rielvanm/VRI_Datalogger_/Tussentijdse_rapportage/5 april1.jpg

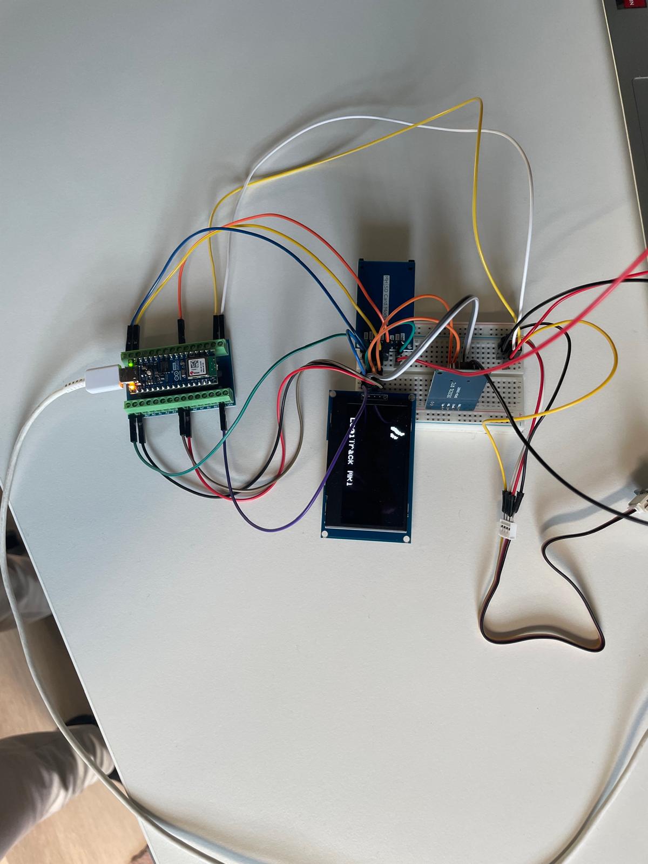
Tussentijdse_rapportage/5 april1.jpg
