rielvanm/VRI_Datalogger_/Tussentijdse_rapportage/iCloud‑foto’s/iCloud‑foto’s/IMG_2985.JPEG

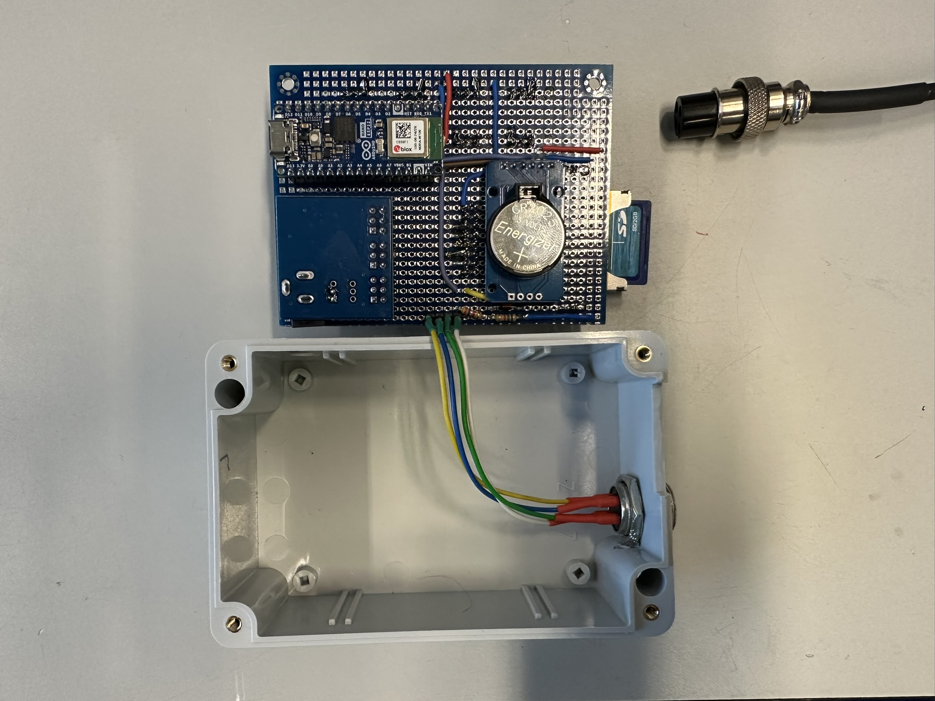
Tussentijdse_rapportage/iCloud‑foto’s/iCloud‑foto’s/IMG_2985.JPEG
