rielvanm/VRI_Datalogger_/Productdocument_bijlagen/Ontwerp.pptx

12V aansluiting

Oled-scherm 128X64 pixels
Afmeting: 6X4 cm

SD Gereed
Tijd: 21:17;23
Dat: 2025-03-14
Meting gestopt

IR: X

SD: 0

RIT:

00

Stop

Start

Klok

GPS

Behuizing maximaal 12x8x5cm (lxbxh)

Ingang lichtpoortsensor

Vier buttons
