rielvanm/VRI_Datalogger_/Plan van Aanpak/Onderzoek.docx

Onderzoeksvraag:

"Welke hard- en software is het meest efficiënt en effectief voor een datalogger, die nauwkeurig de tijdwaarneming kan loggen na een inkomend signaal?"

1. Opdelen van de vraag in subvragen:

- Wat zijn de functionele eisen voor een datalogger met nauwkeurige tijdsregistratie?
  - Wat betekent "nauwkeurige tijdwaarneming" in deze context? (milliseconden, microseconden, nanoseconden?)

De datalogger moet in 0,1 milliseconden registreren. Deze frequentie is ook vastgelegd in een FO-norm, waarin de validatie van verkeersregelinstallaties moeten plaatsvinden. Daarnaast registeren de dataloggers die momenteel in bezit zijn bij de politie, ook in 0,1 ms. Er is geen reden om de nauwkeurigheid te vergroten of te verminderen.

  - Welke soorten signalen moeten worden geregistreerd? (digitaal, analoog, pulsbreedte, etc.)

Noodzakelijk voor de datalogger zijn de volgende signalen (voor de latere modules):

Digitaal → Voor schakelaars en detectiesensoren (O5D150 digitale uitgang, knoppen, GPS-data);

Analoog → Voor continue metingen zoals afstand (O5D150 analoge uitgang, na spanningsdeler);

Seriële data (UART/I²C/SPI) → Voor communicatie met display, SD-kaart, RTC en GPS.

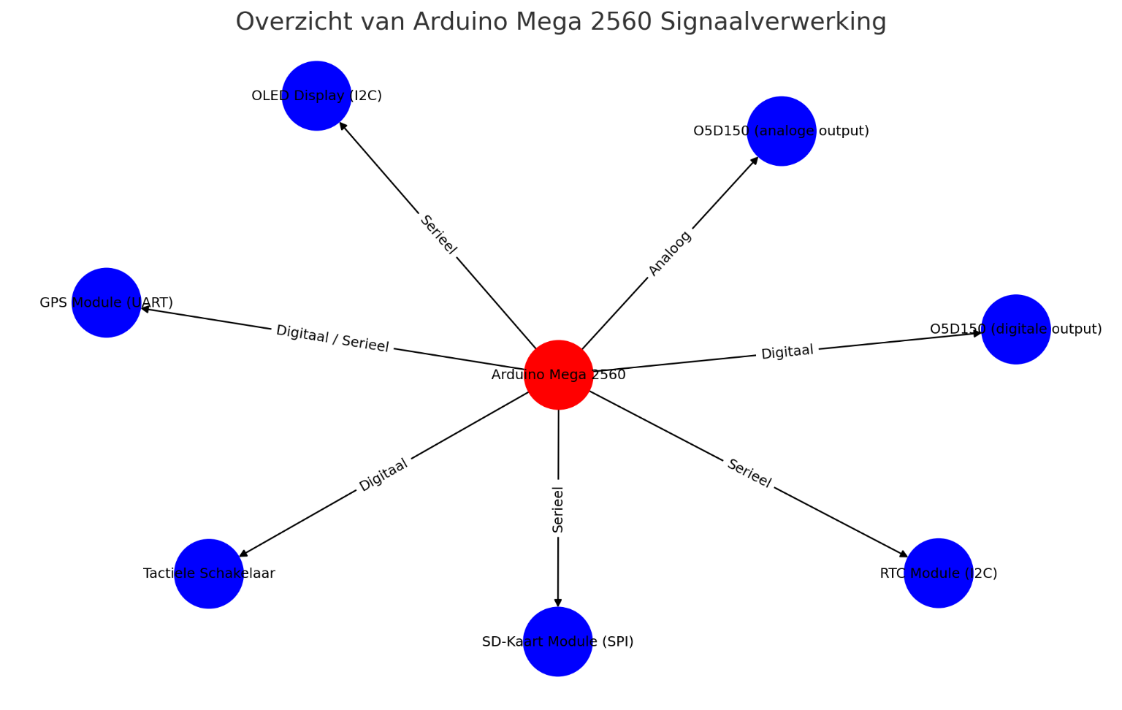
[picture p24: figure]
Uitvoerafbeelding

- Welke hardwarecomponenten zijn geschikt voor een datalogger met hoge tijdsnauwkeurigheid?
  - Welke microcontrollers, FPGA’s of andere embedded systemen kunnen dit aan?

Microcontrollers en Embedded Systemen:

- STM32-serie: Deze microcontrollers van STMicroelectronics staan bekend om hun hoge prestaties en nauwkeurige timers, wat essentieel is voor tijdkritische toepassingen.
- ESP32: Een krachtige microcontroller met ingebouwde Wi-Fi en Bluetooth, geschikt voor real-time toepassingen dankzij zijn dual-core processor en precisietimers.
- Teensy 4.1: Een geavanceerde microcontroller met een 600 MHz ARM Cortex-M7 processor, die hoge snelheid en nauwkeurigheid biedt voor datalogging.

FPGA's (Field-Programmable Gate Arrays):

- Xilinx Spartan-serie: Deze FPGA's bieden hoge mate van parallelisme en kunnen complexe, tijdkritische taken met minimale latentie uitvoeren.
- Intel Cyclone-serie: Bekend om hun efficiëntie en prestaties, geschikt voor toepassingen die een hoge tijdsnauwkeurigheid vereisen.

Voordelen van FPGA's:

- Parallelle verwerking: FPGA's kunnen meerdere processen gelijktijdig uitvoeren, wat resulteert in minimale latentie.
- Hoge flexibiliteit: Ze kunnen worden geherconfigureerd voor specifieke taken, wat ze geschikt maakt voor diverse toepassingen.

Nadelen van FPGA's:

- Complexiteit in programmering: Het vereist gespecialiseerde kennis van hardware description languages zoals VHDL of Verilog.
- Hogere kosten: Zowel de hardware als de ontwikkeltools kunnen duurder zijn in vergelijking met microcontrollers.
  - Wat zijn de voordelen en nadelen van verschillende hardwareplatformen (bijv. Arduino, Raspberry Pi, STM32, KL25Z, FPGA’s)?

Platform | Voordelen | Nadelen
Arduino | - Gebruiksvriendelijk en breed ondersteund. - Ideaal voor beginners en snelle prototyping. | - Beperkte rekenkracht en precisie. - Minder geschikt voor zeer tijdkritische toepassingen. - Geen RTOS (Wel ondersteuning voor FreeRTOS)
Raspberry Pi | - Krachtige single-board computer met uitgebreide connectiviteitsopties. - Geschikt voor complexe toepassingen en dataverwerking. | - Draait op een besturingssysteem, wat kan leiden tot minder voorspelbare timing. - Hogere stroomverbruik.
STM32 | - Hoge prestaties met nauwkeurige timers. - Lage stroomverbruik, geschikt voor embedded toepassingen. | - Complexere ontwikkelomgeving vergeleken met Arduino. - Vereist meer technische kennis.
KL25Z | - Kosteneffectief met redelijke prestaties. - Ondersteuning voor diverse interfaces. | - Minder krachtige processor in vergelijking met STM32. - Beperkte community-ondersteuning.
FPGA's | - Uitstekende parallelle verwerking en lage latentie. - Hoge mate van flexibiliteit en herconfigureerbaarheid. | - Hoge complexiteit in ontwerp en implementatie. - Hogere kosten en stroomverbruik. - Beperkte RTOS ondersteuning

  - Welke externe componenten kunnen helpen (bijv. RTC’s, GPS-modules, kristaloscillatoren)?
- RTC's (Real-Time Clocks): Deze modules bieden nauwkeurige tijdkeeping en zijn essentieel voor toepassingen die exacte tijdstempels vereisen.
- GPS-modules: Naast locatie-informatie kunnen GPS-modules zeer nauwkeurige tijdsignalen leveren, gesynchroniseerd met atoomklokken, wat cruciaal is voor systemen die absolute tijdsynchronisatie nodig hebben.
- Kristaloscillatoren: Hoge-precisie kristaloscillatoren kunnen de klokstabiliteit van microcontrollers verbeteren, wat leidt tot betere tijdsnauwkeurigheid in dataloggingtoepassingen.

### Conclusie

De keuze van hardware voor een datalogger met hoge tijdsnauwkeurigheid hangt af van de specifieke eisen van mijn project. Microcontrollers zoals de STM32 bieden een balans tussen prestaties en complexiteit, terwijl FPGA's ongeëvenaarde snelheid en flexibiliteit bieden voor zeer tijdkritische toepassingen. Het integreren van externe componenten zoals RTC's, GPS-modules en hoogwaardige kristaloscillatoren kan de tijdsnauwkeurigheid verder verbeteren.

- Welke softwareframeworks en programmeertalen zijn geschikt?
  - Welke softwarebibliotheken of frameworks ondersteunen precieze tijdsregistratie?

Er zijn meerdere bibliotheken en frameworks die geschikt zijn voor precieze tijdsregistratie in embedded systemen en dataloggers. De keuze hangt af van de hardware en de gewenste nauwkeurigheid.

- Voor microcontrollers en real-time systemen
  - FreeRTOS (Real-Time OS voor embedded systemen)
    - Ondersteunt precieze timers en scheduling met prioriteiten.
    - Geschikt voor STM32, ESP32, Arduino, en andere microcontrollers.
  - mbed OS (van ARM)
    - Ondersteunt low-latency hardware-interrupts en tijdmeting.
  - Arduino Time Library
    - Beschikbaar voor eenvoudige dataloggers die millisecondenprecisie vereisen.
- Voor Linux-gebaseerde embedded systemen
  - Linux clock_gettime() API
    - Ondersteunt resoluties tot nanoseconden, afhankelijk van de gebruikte hardware.
  - Xenomai (Real-Time Linux Extension)
    - Voegt real-time capaciteiten toe aan Linux voor microseconden-nauwkeurigheid.
  - RT-PREEMPT Kernel Patch
    - Zorgt ervoor dat Linux geschikt is voor real-time toepassingen.
- Voor FPGA-gebaseerde datalogging
  - Verilog/VHDL met Precision Timing Modules
    - Voor ultra-lage latency tijdsregistratie (nanoseconden-niveau).
  - Xilinx Vitis & Intel Quartus Timing Analysis
    - Voor FPGA-gebaseerde tijdstempellogging met sub-nanoseconden precisie.
  - Wat zijn de verschillen tussen real-time besturingssystemen (RTOS) en standaard besturingssystemen zoals Linux?

Kenmerk | RTOS (Real-Time OS) | Linux (standaard OS)
Tijdsresolutie | Microseconden tot nanoseconden | Milliseconden tot microseconden
Determinisme | Zeer voorspelbaar | Minder voorspelbaar (afhankelijk van scheduler)
Gebruik in embedded systemen | Geschikt voor microcontrollers | Geschikt voor SBC’s zoals Raspberry Pi
Voorbeelden | FreeRTOS, Zephyr, mbed OS | Ubuntu, Debian, Yocto Linux
Toepassingen | Industriële besturing, precisie-logging | Servertoepassingen, complexe dataverwerking

Conclusie: Als ik zeer nauwkeurige en deterministische tijdregistratie nodig heb (bijv. ≤ 1 µs), is RTOS of een FPGA-oplossing geschikter. Voor minder kritische toepassingen kan Linux met een real-time patch voldoen.

  - Welke programmeertalen zijn het meest geschikt voor het verwerken van inkomende signalen met minimale vertraging?
- C / C++
  - Efficiënt en direct toegankelijk tot hardware.
  - Wordt gebruikt in microcontrollers en RTOS (FreeRTOS, Zephyr).
- Rust
  - Biedt lage latency en veilig geheugenbeheer (handig voor complexe systemen).
  - Wordt steeds vaker gebruikt in embedded toepassingen.
- Python met C-extensies
  - Niet real-time geschikt, maar handig voor snelle prototyping en data-analyse.
  - Kan met NumPy of Cython worden geoptimaliseerd.
- Verilog/VHDL (voor FPGA's)
  - Uiterst geschikt voor ultrasnelle tijdsregistratie.

Conclusie: C/C++ is de standaardkeuze voor embedded real-time verwerking, terwijl Rust opkomt als veilig alternatief. Python kan nuttig zijn voor analyse na de datalogging.

- Hoe kan de efficiëntie en effectiviteit van verschillende hardware- en softwarecombinaties worden vergeleken?
  - Wat zijn de meetcriteria voor efficiëntie (energieverbruik, snelheid, latency, opslagcapaciteit)?

A. Energieverbruik (mW of mAh)

- Waarom belangrijk? In batterijgevoede systemen bepaalt het energieverbruik de operationele levensduur.
- Meetmethode:
  - Gebruik een elektronische belastingmeter of een Shunt-resistor + ADC om het stroomverbruik te meten.
  - Meet in actieve modus, slaapmodus en logging-operatie.
- Tools:
  - Nordic Power Profiler Kit (PPK2) voor embedded hardware.
  - Otii Arc voor geavanceerde energieprofielen.

B. Snelheid (verwerkingssnelheid in kHz of MHz)

- Waarom belangrijk? Hoe sneller de hardware data kan verwerken, hoe minder vertraging er optreedt.
- Meetmethode:
  - Interrupt latency testen: Laat een GPIO-pin een puls genereren en meet de reactietijd van de software.
  - Verwerkingstijd: Log een dataset van vaste grootte en meet hoe snel deze wordt opgeslagen.
  - CPU-gebruik meten: Gebruik ingebouwde timers (bijv. clock() in C) of benchmarking-tools (sysbench op Linux).

C. Latency (in microseconden of nanoseconden)

- Waarom belangrijk? Hoe korter de tijd tussen een inkomend signaal en de logging, hoe beter.
- Meetmethode:
  - Gebruik een oscilloscoop om de vertraging tussen een inkomend signaal en de registratie te meten.
  - Meet software-latency door tijdstempels voor en na verwerking te vergelijken.
  - Vergelijk polling, interrupts en DMA (Direct Memory Access).
- Hardware met lage latency: FPGA’s (Xilinx, Intel), high-end microcontrollers (Teensy 4.1, STM32H7).

D. Opslagcapaciteit (MB/s of GB)

- Waarom belangrijk? Een hoger datavolume vereist snellere en grotere opslag.
- Meetmethode:
  - Meet de maximale datadoorvoer naar SD-kaart, SSD of cloud.
  - Gebruik benchmarktools zoals dd of fio op Linux voor opslagperformance.
  - Hoe kan de effectiviteit worden gemeten (nauwkeurigheid van tijdregistratie, consistentie, fouttolerantie)?

A. Nauwkeurigheid van tijdregistratie (in microseconden of nanoseconden)

- Waarom belangrijk? Hoe beter de nauwkeurigheid, hoe betrouwbaarder de meetdata.
- Meetmethode:
  - Gebruik een referentieklok (bijv. GPS, rubidium-oscillator) en vergelijk tijdstempels.
  - Vergelijk klokken van RTC-modules, interne kristallen en externe oscillatoren.
  - Gebruik phase-locked loops (PLL) voor synchronisatie.

B. Consistentie (herhaalbaarheid van metingen)

- Waarom belangrijk? Variaties in metingen kunnen duiden op hardware- of softwareproblemen.
- Meetmethode:
  - Voer herhaalde tests uit en bereken de standaardafwijking (σ).
  - Check jitter (variatie in latency over de tijd).
  - Gebruik oscilloscopen en data-analyse tools (MATLAB, Python Pandas).

C. Fouttolerantie (resilience tegen storingen)

- Waarom belangrijk? Een betrouwbare datalogger moet kunnen omgaan met storingen.
- Meetmethode:
  - Simuleer spanningsschommelingen en stroomonderbrekingen.
  - Controleer foutcorrectiemechanismen (bijv. CRC-checks, redundante logging).
  - Test met EMI (elektromagnetische interferentie) simulaties.
  - Zijn er benchmarks of eerdere studies over de prestaties van verschillende dataloggers?

A. Wetenschappelijke artikelen en publicaties

- "Real-Time Data Acquisition and Logging for Automotive Applications"
  - IEEE-paper over latency-optimalisatie in CAN-bus datalogging.
- "High-Precision Timestamping in Embedded Systems"
  - arXiv-publicatie over tijdregistratie met FPGA’s en microcontrollers.
- "Power-Efficient Data Logging for IoT Sensors"
  - Springer-publicatie over low-power datalogging optimalisaties.

B. Industriële benchmarks

- Bosch Motorsport Dataloggers (C70, C80)
  - Specificaties over 10 kHz logging, CAN-bus synchronisatie en latencies.
- Raspberry Pi vs. STM32 in real-time logging
  - Vergelijking van Linux-gebaseerde logging versus RTOS-gebaseerde microcontrollers.
- Welke bestaande toepassingen en wetenschappelijke studies kunnen als referentie dienen?
  - Welke wetenschappelijke papers of industriële rapporten zijn er over tijdsregistratie in dataloggers?
  - Zijn er praktijkvoorbeelden uit de automotive sector, industriële monitoring of IoT?

2. Betrouwbare bronnen en methoden om antwoorden te vinden

Om deze deelvragen te beantwoorden, heb je verschillende typen bronnen nodig:

1. Wetenschappelijke artikelen & technische papers
  - Zoek in Google Scholar, IEEE Xplore, arXiv, en ScienceDirect naar papers over tijdregistratie in embedded systemen en datalogging.
  - Gebruik zoektermen zoals:
    - High precision data logging microcontroller
    - Timestamp accuracy in embedded systems
    - Real-time data logging performance FPGA vs. microcontroller
2. Boeken & vakliteratuur
  - Zoek naar boeken over embedded systemen, dataloggers en tijdkritische toepassingen.
  - Websites zoals SpringerLink of MIT Press hebben vaak goede academische boeken.
3. Datasheets en whitepapers van hardwarefabrikanten
  - Voor de hardwarekeuze kun je datasheets van microcontrollers en FPGA’s vergelijken op hun clock precisie, interrupt latency en event timestamping mogelijkheden.
  - Check bijvoorbeeld:
    - NXP KL25Z datasheet (mogelijk interessant voor jouw toepassing)
    - STM32 real-time clock (RTC) en timerfunctionaliteit
    - Xilinx en Intel FPGA’s voor tijdkritische verwerking
4. Open-source projecten en technische blogs
  - Kijk op GitHub, Hackaday, Stack Exchange (Electrical Engineering & Embedded Systems) voor open-source implementaties van dataloggers.
  - Blogs zoals EEVblog, All About Circuits, en Embedded.com geven vaak praktische inzichten over de efficiëntie van hardware en software.
5. Vergelijkende tests en benchmarks
  - Industriële tests of universitaire studies over het vergelijken van verschillende hardware en software voor tijdkritische toepassingen.
  - Zoek naar benchmarks in IEEE-papers over real-time performance in embedded systems.

3. Structuur van je onderzoek

Om je onderzoek logisch en wetenschappelijk onderbouwd te maken, kun je deze structuur hanteren:

1. Inleiding
  - Context: Waarom is nauwkeurige tijdregistratie belangrijk?
  - Probleemstelling: De uitdaging van het kiezen van de juiste hard- en software.
  - Onderzoeksvraag en deelvragen.
2. Theoretisch kader
  - Wat is een datalogger en hoe werkt tijdregistratie?
  - Welke factoren beïnvloeden de precisie?
  - Beschrijving van latency, sampling rates en signaalverwerking.
3. Methodologie
  - Hoe worden verschillende hardware- en softwareoplossingen vergeleken?
  - Welke testopstellingen en meetmethodes worden gebruikt?
4. Resultaten & Analyse
  - Vergelijking van verschillende systemen op basis van nauwkeurigheid, energieverbruik, snelheid.
  - Grafieken en tabellen met meetresultaten.
5. Conclusie & Aanbevelingen
  - Samenvatting van de meest efficiënte en effectieve hardware/software-combinatie.
  - Toepassingsgebieden en verdere onderzoeksmogelijkheden.
