rielvanm/VRI_Datalogger_/Productdocument/Bijlage/Ilustraties/Microcontroller.pptx

Microcontroller

UART

SPI

SPI

I2C

GPIO

initGPS(), updateGPS()

initSD(), writeLine()

initRTC(), getTime(), initDisplay(), showMessage()

readButtons()

ISR:handleInetrrupt()
