rielvanm/VRI_Datalogger_/Productdocument/Bijlage/Ilustraties/Switch.pptx

Microcontroller

ButtonManager

ButtonManager::begin()

ButtonManager::readButtons()

ButtonManager::readSecondButtons()
