rielvanm/VRI_Datalogger_/Plan van Aanpak/Onderzoek_Bijlage/Switch/Switch.pdf

## Tactile Momentary Push Button White 12mm

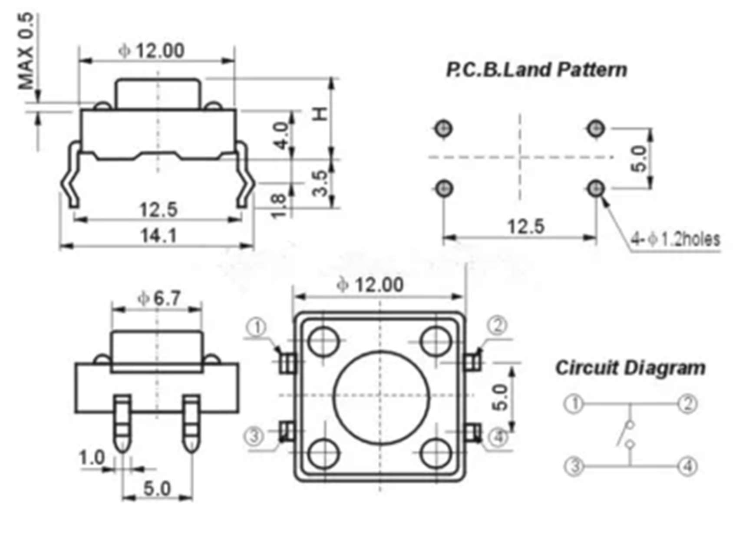
[picture p40: figure]

Description
Momentary contact, round push button, 4 pins, through hole tact switch.
- Push-button Switch
- catching clamps and buttons.
- 12 x 12mm Push Button Switch with white round cap.
- Overall height: 15mm
