rielvanm/VRI_Datalogger_/Op te ruimen/pinbezetting.docx

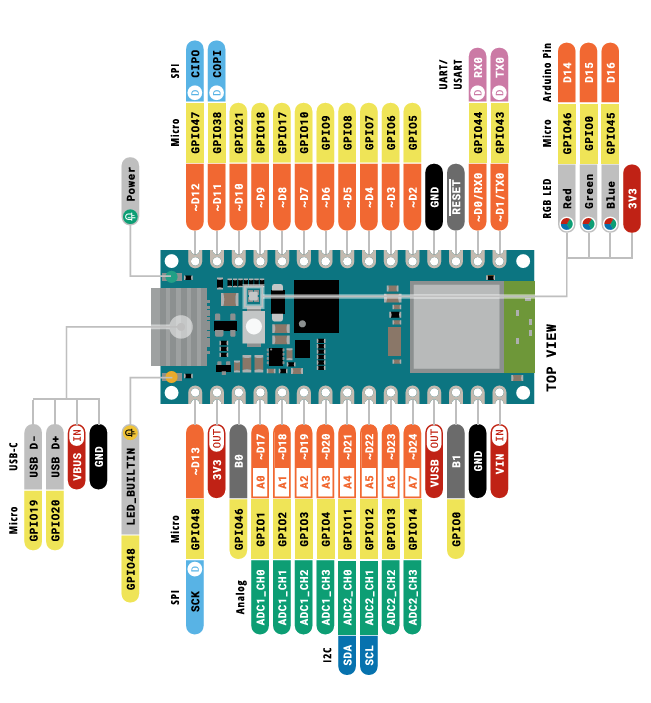
[picture p41: figure]
Afbeelding met tekst, schermopname, diagram, ontwerp Door AI gegenereerde inhoud is mogelijk onjuist.
