rielvanm/VRI_Datalogger_/Plan van Aanpak/Plan van Aanpak.docx

| | Plan van Aanpak Datalogger voor het valideren van tijdwaarneming verkeersregelinstallatie
| | | Student : Maarten van Riel Versie : 0.1 Datum : 30 januari 2025

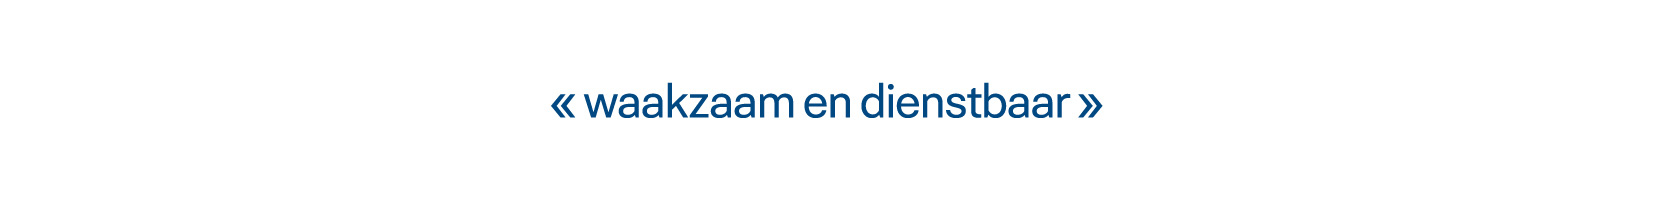
[picture p42: figure]
footer

Eenheid Zeeland – West Brabant

Dienst Regionale Recherche

Afdeling Specialistische Ondersteuning

Team Forensische Opsporing

Postbus 8050

5004 GB Tilburg

Tel. +31 88 9635060

## Algemeen

## Opdrachtgever en betrokkenen

Opdrachtgever : Nationale Politie

Contactpersoon : Mark Bos, (Mark.Bos@politie.nl)

Bezoekadres : Nieuwe Uitleg 1

Postcode / Plaats : 2514 AR Den Haag

Telefoon : 0343 578844

Opdrachtnemer : Politie Zeeland West Brabant

Contactpersoon : Maarten van Riel (Maarten.van.Riel@politie.nl)

Bezoekadres : Ringbaan West 232

Postcode / Plaats : 5038 KE Tilburg

Telefoon : 088-9635060

Docentbegeleider : Hogeschool Arnhem & Nijmegen (HAN)

Contact persoon : Peter Bijl (Peter.Bijl@han.nl)

Bezoekadres : Ruitenberglaan 29

Postcode : 6826 CC, Arnhem (Engineering)

Telefoon : 06 55208764

## Mutatieoverzicht

Datum | Versie | Auteur | Mutaties
30 januari 2025 | 0.1 | M. van Riel | Eerste versie

Tabel 1: Mutatieoverzicht.

# 1 Inleiding

## 1.1 Beknopte beschrijving

Dit plan van aanpak (PvA) beschrijft de aanpak voor het afstudeerproject waarin een embedded apparaat wordt ontworpen en ontwikkeld. Het doel is om een technisch probleem te analyseren, een oplossing te ontwerpen en deze te implementeren. Dit omvat zowel de hardware- als softwareontwikkeling van een datalogger die gebruikt wordt voor forensisch onderzoek naar verkeersongevallen. Het PvA dient als leidraad voor het project en wordt gebruikt om de voortgang te monitoren en afwijkingen te onderbouwen.

## 1.2 Aanleiding

Bij ernstige verkeersongevallen onderzoekt het team Forensische Opsporing de toedracht. Op kruispunten met een verkeersregelinstallatie (VRI) slaat de VRI-computer relevante data op. Wanneer een voertuig het kruispunt nadert, registreert een detectielus verstoringen in het magnetische veld, die worden gelogd. Deze data kan inzicht geven in snelheid en roodlichtnegatie.

Een cruciaal aspect hierbij is de nauwkeurigheid van de tijdstempel. De VRI-computer registreert tijdswaarden met een resolutie van 0,1 seconde (10 Hz), wat kan leiden tot afrondingsverschillen. Deze tijdsregistratie wordt gebruikt om de snelheid van een voertuig tussen de detectielussen te berekenen. De politie gebruikt een datalogger om de tijdstempels van de VRI-computer te valideren en eventuele afrondingsverschillen vast te stellen (zie tabel 2). Een afwijking van 0,1 seconde kan een snelheidsonzekerheid tot 30 km/h veroorzaken.

De huidige datalogger voldoet echter niet meer aan de eisen. De tekortkomingen liggen onder andere op het gebied van verouderde hard- en software en het mist enkele functionaliteiten. Daarom krijg ik de mogelijkheid om een nieuw en verbeterd model te ontwikkelen, met een focus op betrouwbaarheid, gebruiksgemak en toekomstbestendigheid.

## 1.3 Doel document

Dit plan van aanpak dient als leidraad voor de afstudeerperiode en beschrijft de opdracht, methoden en verwachte resultaten. Daarnaast fungeert het als toetsingskader om de voortgang en kwaliteit van het project te bewaken en als communicatiemiddel tussen de betrokken partijen, zoals de opdrachtgever, de begeleider en andere stakeholders.

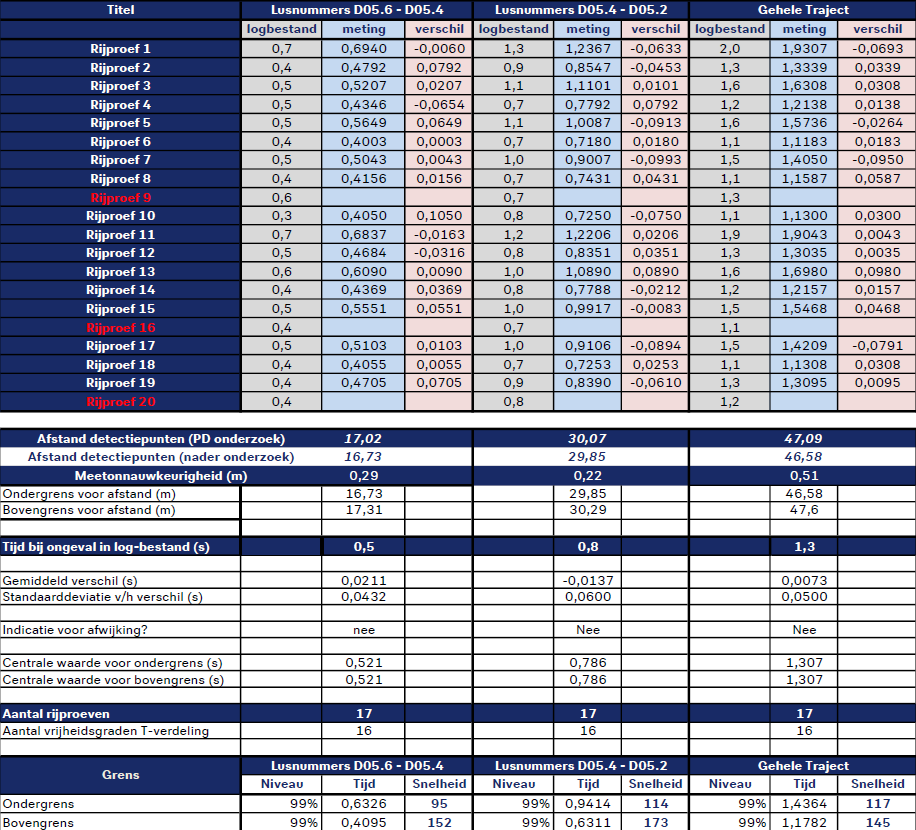
[picture p43: figure]

Tabel 2: Rekenblad van validatieonderzoek (Bron: rechtspraak ECLI:NL:RBZWB:2023:8013).

# 2 Probleemanalyse en opdrachtomschrijving

## 2.1 Probleemstelling

De politie maakt gebruik van verschillende meetinstrumenten. Binnen de nationale politie zijn er 11 teams Forensische Opsporing, waarvoor meetapparatuur bij voorkeur centraal wordt ingekocht. Dit gebeurt meestal via een landelijke aanbesteding, waarbij alle teams inspraak hebben in de functionaliteiten. Omdat de politie vaak specifieke metingen uitvoert, worden er compromissen gesloten om een apparaat te kiezen dat zo breed mogelijk inzetbaar is. Maatwerk wordt zelden overwogen vanwege de hoge kosten en lange levertermijnen.

Meetapparaten gaan gemiddeld tien jaar mee, inclusief onderhoudscontract. Momenteel zijn er verschillende meetinstrumenten in omloop, waaronder een datalogger die wordt gebruikt voor validatieonderzoek bij verkeersregelinstallaties (zie afbeelding 1). Dit apparaat is echter uitgefaseerd; het onderhoudscontract is verlopen en reparaties zijn niet meer mogelijk, want reserveonderdelen zijn nauwelijks verkrijgbaar. De software van de datalogger is niet compatible met de huidige versie van Windows. Hierdoor ontstaat de noodzaak voor een vervangend meetinstrument.

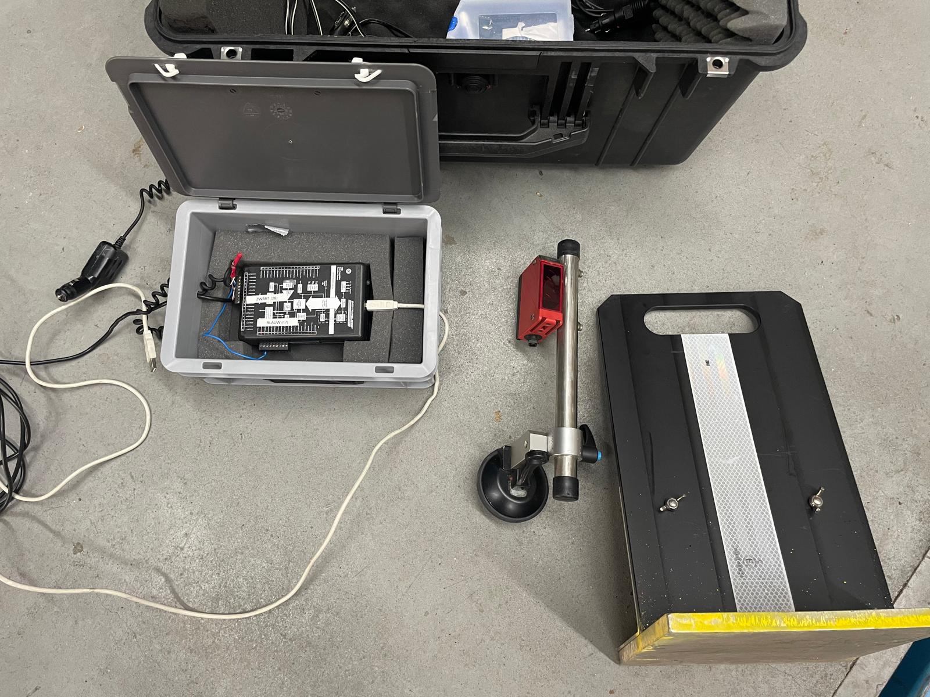
[picture p44: figure]

Afbeelding 1: De huidige datalogger voor de VRI.

## 2.2 Doelstelling

Het doel van dit project is het ontwikkelen van een functionerende prototype-datalogger die tijdens rijproeven nauwkeurig de tijdwaarneming kan vastleggen. Dit apparaat moet de huidige, verouderde datalogger vervangen en specifiek worden ingezet voor de validatie van verkeersregelinstallaties (VRI).

Omdat de afstudeerperiode beperkt is, richt het project zich op het ontwerpen en implementeren van één werkend prototype met een functionele module voor VRI-validatie. De focus ligt op:

- Ontwikkeling van een embedded hardware-oplossing met de juiste aansluitingen en interfaces.
- Implementatie van software/firmware voor het vastleggen en verwerken van meetdata.
- Betrouwbare tijdwaarneming en synchronisatie voor forensisch gebruik.
- Modulariteit, zodat toekomstige functionaliteiten eenvoudig kunnen worden toegevoegd.

Het eindproduct van dit project is een werkend prototype dat voldoet aan de functionele eisen voor VRI-validatie. Volledige implementatie en integratie in politieprocessen vallen buiten de scope.

## 2.3 Eindresultaat

Het eindresultaat van dit project is een functionerende datalogger die tijdens referentieritten betrouwbare meetgegevens registreert en opslaat. De datalogger wordt gebruikt in een referentievoertuig voor de validatie van detectielussen. Aan de buitenzijde van het voertuig wordt een optische sensor toegepast om referentiepunten te detecteren. Met het referentievoertuig worden meerdere referentieritten gereden, met verschillende snelheden. Na afloop worden de tijdwaarnemingen van de datalogger en de computer van de datalogger met elkaar vergeleken om de nauwkeurigheid vast te stellen. De datalogger zal een handzaam formaat krijgen.

De datalogger zal de volgende functionaliteiten bevatten:

- Detectie van referentiepunten met behulp van een optisch meetsysteem;
- Tijdwaarneming met hoge precisie (1000 Hz) voor nauwkeurige positiebepaling;
- Opslag van meetgegevens voor latere analyse en validatie;
- Een gebruikersinterface waarmee instellingen kunnen worden aangepast en meetgegevens kunnen worden gecontroleerd;
- Robuuste en modulaire architectuur, zodat de datalogger eenvoudig kan worden uitgebreid met extra functionaliteiten.

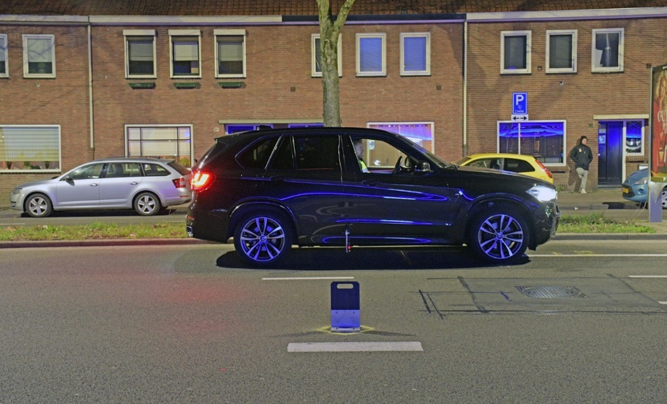
[picture p45: figure]

Afbeelding 2: Referentievoertuig tijdens positioneren lusdetectie.

Om te valideren of de ontwikkelde datalogger correct functioneert, zal een testsysteem worden opgezet waarmee meetresultaten geverifieerd kunnen worden. Dit testsysteem valt binnen de scope van dit project. Dit project richt zich uitsluitend op de ontwikkeling en initiële testfase van de datalogger. Volledige implementatie en integratie in het politieproces vallen buiten de projectomvang.

# 3 Projectactiviteiten en Fasering

Dit project bestaat uit verschillende stappen die ik ga nemen om het project en de afstudeeropdracht te kunnen voltooien. Door mij zijn in dit hoofdstuk een overzicht van de stappen weergegeven en hoe deze in de tijd worden gepland.

3.1 Overzicht Activiteiten

Oriëntatie & Analyse

- Probleemanalyse.
- Wat is de huidige vorm van valideren?
- Gebruikerseisen en randvoorwaarden specificeren.
- Projectplanning.
- Plan van aanpak;

Onderzoek

Hoofdonderzoeksvraag:

Welke hard- en software is het meest efficiënt en effectief voor een datalogger, die nauwkeurig de tijdwaarneming kan vergelijken na een inkomend signaal?

Subvragen:

- Welke hardwarecomponenten zijn geschikt voor het detecteren en verwerken van een inkomend signaal met een hoge nauwkeurigheid?
- Welke software-architectuur zorgt voor een efficiënte verwerking en opslag van tijdstempels?
- Wat zijn de prestatie-eisen voor een nauwkeurige tijdsvergelijking?
- Welke opslag- en verwerkingsmogelijkheden zijn nodig voor langdurige logging?
- Hoe kan de datalogger worden getest en gevalideerd op nauwkeurigheid?

Ontwerp (functioneel en technisch)

- Systeemarchitectuur en interface.
- Gedetailleerd ontwerp van componenten.

Realisatie (prototypeontwikkeling)

- Code schrijven en prototype bouwen.

Documentatie en Oplevering

- Unit testen.
- Integratietesten.
- Systeemtesten.
- Acceptatietesten.
- Systeemvalidatie door het NMI of NFI.
- Oplevering eindproduct.
- Documenteren.

# 4 Kwaliteitswaarborging en Methodologie

Om de kwaliteit van het eindproduct en de uitvoering van het project te borgen, zijn door er kwaliteitseisen, werkwijze en methodes en vastgesteld in dit hoofdstuk.

4.1 Kwaliteitseisen

Het eindproduct moet voldoen aan de volgende kwaliteitseisen:

1. Bedieningsgemak & gebruiksvriendelijkheid
- De interface moet intuïtief en eenvoudig te bedienen zijn.
- Installatie en configuratie moeten duidelijk en zonder specialistische kennis mogelijk zijn.
- Knoppen en menu’s moeten logisch en toegankelijk zijn.
2. Betrouwbaarheid & robuustheid
- Storingen moeten eenvoudig op te lossen zijn, bijvoorbeeld door een foutdiagnosesysteem of logging.
- Het systeem moet langdurig kunnen werken zonder handmatige herstarten of resets.
- Hardware en behuizing moeten bestand zijn tegen trillingen en temperatuurschommelingen.
3. Nauwkeurigheid & prestaties
- De klok moet een frequentie van 1000 Hz (1 ms nauwkeurigheid) halen.
- Latency van signaaldetectie moet minimaal zijn.
- Synchronisatie tussen verschillende componenten moet binnen een acceptabele foutmarge blijven (bijv. max. afwijking ± 1 ms).
4. Opslag & data-integriteit
- Gegevens moeten consistent en foutloos worden weggeschreven naar een USB-stick of SD-kaart.
- Bestandsgrootte en opslagformaat moeten geoptimaliseerd zijn voor snelle uitlezing en verwerking.
- Data mag niet verloren gaan bij een stroomstoring of herstart.
5. Sensorvalidatie & foutpreventie
- Valse detecties van de laserafstandssensor moeten worden geminimaliseerd door filtering of signaalverwerking.
- Omgevingsfactoren (lichtinval, stof, obstakels) mogen de werking niet beïnvloeden.

4.2 Werkwijze en Methodes

Ontwerpmethodologie

- Gevolgd wordt het V-model aanpak: eerst specificeren, ontwerpen, testen en daarna valideren.
- Componenten worden modulair ontworpen zodat aanpassingen per onderdeel mogelijk zijn.
- Documentatie van de software en hardware zodat latere uitbreidingen mogelijk zijn.

Testmethoden

- Unit testing: Elk hardware- en softwarecomponent wordt afzonderlijk getest.
- Integratietesting: De samenwerking tussen componenten wordt getest om communicatieproblemen te detecteren.
- Systeemtesten: De volledige datalogger wordt getest met real-world inputs.
- Validatietesten: De metingen worden vergeleken met een referentieklok om nauwkeurigheid te verifiëren.

Reviewprocessen & feedback

- Wekelijkse evaluaties met praktijkbegeleider.
- Maandelijkse review met externe stakeholders.
- Feedback wordt verwerkt via een versiebeheersysteem.

Versiebeheer

- Gebruik van GitHub.

4.3 Risicomanagement

Bij de ontwikkeling van de nieuwe datalogger zijn er verschillende risico’s die de nauwkeurigheid en betrouwbaarheid kunnen beïnvloeden. In onderstaande tabel staan de belangrijkste risico’s, hun impact en de maatregelen om ze te beheersen.

De focus ligt op een nauwkeurige tijdsregistratie, betrouwbare sensorwaarnemingen en correcte data-opslag. Daarnaast worden mogelijke vertragingen en hardwareproblemen meegenomen in de planning om het project soepel te laten verlopen.

Risico | Impact | Kans | Maatregelen
Nauwkeurigheid lager dan 1000 Hz | Hoog | Middel | Testen met verschillende timers en klokken, optimaliseren code en signaalverwerking.
Sensor detecteert valse signalen | Hoog | Laag | Filtertechnieken implementeren, experimenteren met drempelwaarden.
Data wordt niet correct opgeslagen | Hoog | Middel | Opslagmethodes testen, redundante opslagopties inbouwen (bijv. checksum-controle).
Project loopt uit door technische complexiteit | Hoog | Middel | Strikte planning en prioritering van kritieke onderdelen.
Hardware-componenten niet op tijd beschikbaar | Middel | Hoog | Alternatieve componenten identificeren en testopstelling maken met vervangbare modules.

Tabel 3: Risico inventarisering.

# 5 Projectgrenzen

Het is belangrijk de grenzen van de werkzaamheden te definiëren, omdat de datalogger deel uitmaakt van een groter project. In dit hoofdstuk wordt beschreven welke activiteiten binnen en buiten de scope vallen.

## 5.1 Binnen scope

- Opstellen van eisen: Definitie van functionele en technische eisen.
- Hardware-ontwerp:
  - Selectie en ontwerp van de printplaat (indien nodig).
  - Aansluiting van de microcontroller op sensoren en interface.
  - Voeding en signaalintegriteit.
- Softwareontwikkeling:
  - Microcontroller-code voor data-acquisitie en opslag.
  - Timing en synchronisatie van metingen.
  - Weergave van de live-meetgegevens.
  - Opslag en uitlezing van data.
- Testen en optimaliseren:
  - Valideren van de nauwkeurigheid van de tijdsregistratie.
  - Controleren op storingen en foutafhandeling.
  - Debuggen en optimaliseren van code en signaalverwerking.
- Documentatie:
  - Technische documentatie en gebruikershandleiding.
  - Mogelijkheden voor toekomstige uitbreidingen benoemen.

## 5.2 Buiten scope

- Geavanceerde dataverwerking en analyse: Het verwerken en interpreteren van de verzamelde data gebeurt extern.
- Mechanische behuizing: Geen ontwerp en productie van een specifieke behuizing.
- Ontwerpen van printplaat in Kicad.

# 6 Organisatie en Communicatie

Binnen dit project zijn verschillende belanghebbenden betrokken. Zij hebben een rol in de ontwikkeling, het testen en de uiteindelijke toepassing van de datalogger. Dit hoofdstuk beschrijft wie deze stakeholders zijn en hoe de communicatie met hen wordt vormgegeven.

6.1 Stakeholderanalyse
Men stakeholderanalyse helpt om te bepalen welke partijen belang hebben bij dit project en in welke mate zij invloed uitoefenen. De rollen van stakeholders kunnen worden onderverdeeld in vier categorieën:

- Toeschouwer: Heeft weinig invloed, maar wordt op de hoogte gehouden.
- Geïnteresseerde: Heeft belang bij de uitkomst van het project, maar geen directe invloed.
- Beïnvloeder: Kan de richting van het project bijsturen door advies of eisen.
- Sleutelfiguur: Heeft zowel grote invloed als een groot belang in het project.

In Tabel 1 staat een overzicht van de betrokken stakeholders, hun functie en rol in het project.

Persoon/Organisatie | Functie | Rol
Nikolai Lieshout | Eindgebruiker van de datalogger | Sleutelfiguur/ Beïnvloeder
Forensisch onderzoekers | Gebruikers van de datalogger in het veld | Geïnteresseerde
Peter Bijl | Docentbegleider | Toeschouwer
Mark Bos | Digitaal Rechercheur | Sleutelfiguur/ Beïnvloeder
Aart Spek | Onderzoeker Nederlands Forensisch Instituut | Geïnteresseerde
Softwareontwikkelaar (ik) | Ontwerper en bouwer van het systeem | Sleutelfiguur

Tabel 4: Rolverdeling stakeholders

## 6.2 Communicatie

Een effectieve communicatie tussen de stakeholders is essentieel voor een succesvolle uitvoering van het project. De volgende communicatiemethoden worden gehanteerd:

- Wekelijks overleg met de opdrachtgever om de voortgang te bespreken en feedback te verwerken.
- Periodieke korte rapportages aan de forensisch onderzoekers over testresultaten en functionaliteit.
- Begeleidingsgesprekken met de docent om de afstudeereisen te bewaken (bijv. eens per drie weken).
- Ad-hoc communicatie met hardware- en software-experts via e-mail of Teams bij technische vraagstukken.

Door deze aanpak blijven alle betrokkenen goed geïnformeerd en kan het project efficiënt verlopen.

# 7 Planning

## 7.1 Tijdsplanning en Mijlpalen

Een goed gestructureerde planning is essentieel voor het succesvol afronden van dit project. Tabel 5 geeft een overzicht van de verschillende fases, inclusief de start- en einddata van de activiteiten.

Deze planning dient als richtlijn en is niet leidend. Tegenvallers en uitlopende activiteiten zijn reëel, waardoor sommige onderdelen later kunnen starten dan gepland.

De afstudeerperiode start in week 0 op maandag 3 februari 2025 en eindigt op maandag 2 juni 2025, de uiterste inleverdatum voor de eindrapportage.

Tabel 5: Gantt Chart tijdplanning.

De belangrijkste mijlpalen in dit project zijn (zie rode vlakken in tabel 5):

- Week 3, uiterlijk zondag 2 maart: Afronding Plan van Aanpak.
- Week 6, uiterlijk op zondag 23 maart: Eerste concept Functioneel Ontwerp.
- Week 10, uiterlijk op zondag 20 april: Prototype gereed voor eerste tests.
- Week 13, uiterlijk op zondag 11 mei: Volledige testresultaten beschikbaar.
- Week 14, uiterlijk op zondag 18 mei: Concept Eindrapport gereed.
- Week 16, uiterlijk op maandag 2 juni: Definitieve inlevering eindrapportage.

Omdat ik graag gericht naar deadlines toe werk, zijn mijlpalen in rood gemarkeerd. Zo is direct duidelijk wanneer een onderdeel afgerond moet zijn.

De deadline voor het eindrapport is maandag 2 juni 2025. Het conceptrapport dient uiterlijk zondag 18 mei gereed te zijn, zodat er tijd is om eventuele feedback te verwerken.

## 7.2 Tijdsplanning en Mijlpalen

Het project is opgedeeld in verschillende fasen, waarbij elke fase logisch voortbouwt op de vorige:

1. Initiële onderzoeksfase (Week 1-4): Definitie van eisen, onderzoek en hardwarekeuze.
2. Ontwerpfase (Week 5-9): Opstellen van functioneel en technisch ontwerp, softwareontwikkeling starten.
3. Prototypefase (Week 10-12): Fysiek bouwen en eerste tests uitvoeren.
4. Test- en validatiefase (Week 13-15): Optimalisatie en eindvalidatie van resultaten.
5. Documentatie en afronding (Week 16-17): Rapportage, reflectie en voorbereiden van de eindpresentatie.

Door deze fasering is er voldoende tijd voor ontwikkeling, testen en bijsturing, zodat het eindresultaat aan alle eisen voldoet.

# 8 Competenties en Activiteiten

Tijdens dit project werk ik aan verschillende competenties die aansluiten bij de eisen van de Bachelor Engineering Elektrotechniek, met een specialisatie in Embedded Systems Engineering. In dit hoofdstuk wordt beschreven hoe deze competenties worden toegepast en ontwikkeld. De competenties zijn gebaseerd op de Afstudeergids AD Engineering 2024-2025 (Steenbergen, 2024), waarbij het Domeincompetenties Elektrotechniek (zie Figuur 1) als leidraad is gebruikt.

De mate van competentiebeheersing wordt beoordeeld op vier niveaus, variërend van instroomniveau (0) tot zelfstandig functioneren in complexe, multidisciplinaire contexten (III). Het radarplot in Figuur 1 biedt een visuele weergave van de ontwikkeling van deze competenties binnen de opleiding. In de grafiek vertegenwoordigt de binnenste ring het instroomniveau (0), terwijl de buitenste ring het hoogste niveau (III) aangeeft.

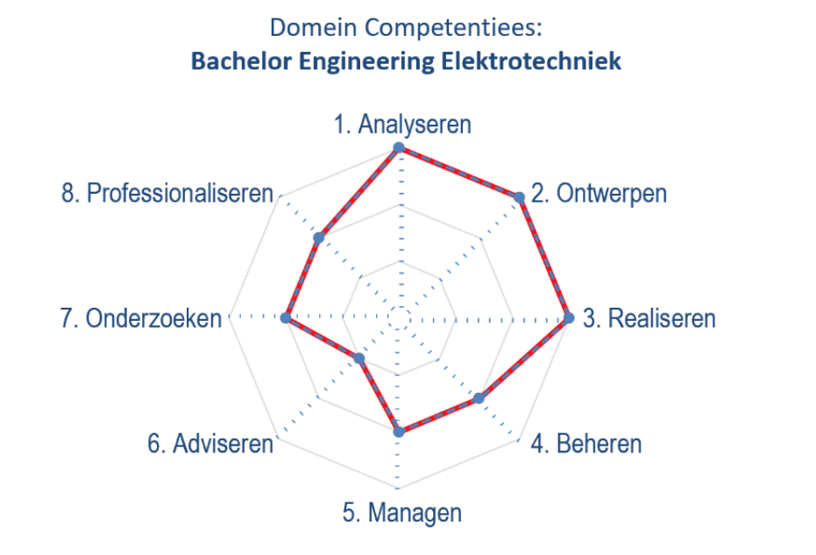
[picture p46: figure]
Afbeelding met tekst, diagram, lijn, schermopname Door AI gegenereerde inhoud is mogelijk onjuist.

Figuur 1: Domein competenties Engineering Elektrotechniek.

## 8.1 SMART Competentiedoelen

1. Analyseren

- Bepalen welke eisen de datalogger moet hebben.
- Controleren hoe nauwkeurig de metingen zijn en waar mogelijke fouten zitten.
- Overleggen met stakeholders om af te stemmen wat de datalogger moet kunnen.
- Onderzoeken welke bestaande systemen en methodes al worden gebruikt voor datalogging.

2. Ontwerpen

- Ontwikkelen van een functioneel en technisch ontwerp voor de datalogger.
- Opstellen van software- en hardware-architectuur.
- Bepalen van de noodzaak en opzet van een testomgeving.
- Keuze en implementatie van geschikte opslag- en communicatiemethoden.

3. Realiseren

- Implementeren van de firmware voor de datalogger.
- Bouwen van een werkend prototype en eerste functionele tests uitvoeren.
- Het systeem verbeteren op basis van testresultaten.

4. Beheren

- Opstellen en bewaken van de projectplanning en fasering.
- Documenteren van ontwerpkeuzes, testresultaten en optimalisaties.
- Structureren van code en hardware keuzes voor toekomstige uitbreidingen.
- Periodieke rapportage aan begeleiders en stakeholders.

5. Managen

- Zorgen voor een tijdige en succesvolle afronding van het project.
- Prioriteren van taken en efficiënte tijdsindeling waarborgen.
- Problemen en tegenslagen signaleren en hierop anticiperen.
- Zorgen voor een goede afstemming met stakeholders en gebruikers.

6. Adviseren

- Stakeholders informeren over de mogelijkheden en beperkingen van de datalogger.
- Beoordelen of de gekozen oplossing voldoet aan de forensische eisen.

7. Onderzoeken

- Vergelijken van verschillende hardware- en softwareopties voor de datalogger.
- Onderzoeken hoe de timing van de meetgegevens geoptimaliseerd kan worden.
- Evalueren van methoden voor foutdetectie en data-integriteit.
- Bepalen hoe de datalogger kan worden geïntegreerd in bestaande systemen.

8. Professionaliseren

- Effectief communiceren met stakeholders en teamleden.
- Zelfstandig werken en verantwoordelijkheid nemen voor projecttaken.
- Proactief problemen signaleren en oplossingen aandragen.
- Reflecteren op eigen werkwijze en feedback toepassen.

## 8.2 Activiteiten en Reflectie

Tijdens dit afstudeerproject voer ik verschillende activiteiten zelfstandig uit die bijdragen aan de ontwikkeling van de hierboven beschreven competenties. Deze activiteiten omvatten zowel technische taken, zoals het analyseren van eisen en het ontwikkelen van firmware, als organisatorische en communicatieve taken, zoals het beheren van de projectplanning en het afstemmen met stakeholders.

Om de voortgang van mijn competentieontwikkeling te bewaken, maak ik gebruik van tussentijdse evaluaties. Dit doe ik door mijn werkzaamheden periodiek te reflecteren, feedback te verzamelen en waar nodig mijn werkwijze aan te passen.

# 9 Bibliografie

Steenbergen, R. (2024). Afstudeergids AD Engineering 2024-2025. Arnhem.

# 10 Conclusie

Dit plan van aanpak dient als leidraad voor het uitvoeren van de afstudeeropdracht. Het biedt een gestructureerde werkwijze en duidelijke doelen om de opdracht succesvol af te ronden. Aanpassingen in het plan worden onderbouwd en besproken met de begeleiders.

## 10.1 Goedkeuring en Handtekeningen

Naam student: Maarten van Riel

Bedrijfsbegeleider: Mark Bos

Datum: 17 februari 2025

Plan van Aanpak Pagina 11 van 11
