rielvanm/VRI_Datalogger_/Productdocument/Bijlage/Ilustraties/SD-kaartmodule.pptx

Microcontroller

DisplayManager

displayManager.begin()

displayManager.setState(Menu)

displayManager.update(time zone, rtcNow)

displayManager.showMessage(“logging gestart”)

displayManager.addUserMessage()

displayManager.showIntro() / showMenu()
