rielvanm/VRI_Datalogger_/Productdocument_bijlagen/Schets_user_interface.pdf

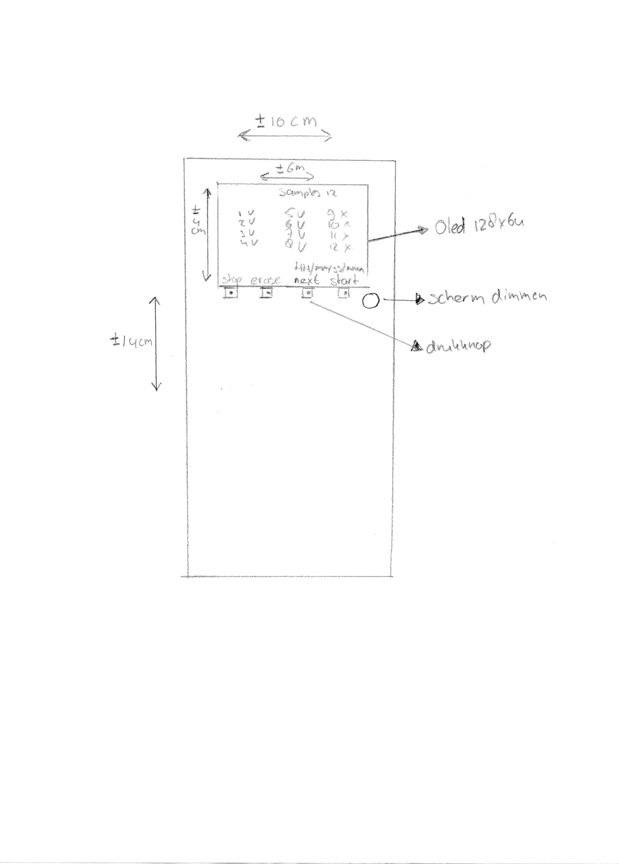
[picture p62: page 1]

t to c wr

+ /it:'

.l | -- | \

\-r/

I
t
;

{.1'}l

rt/ zd
:U\t/

>Qn5fer r?
du ,e:*
sv sfa*'
J lJ ll .;" CÍ fur i?. f

f,

Otd tz$Y6u

)Che.rtn $'irn"nvten

4$ut,rl't\turc.'P

tIqcn

V

o

t-tt
