rielvanm/VRI_Datalogger_/DoxyWizard/html/LogiTrack_MR1.jpg

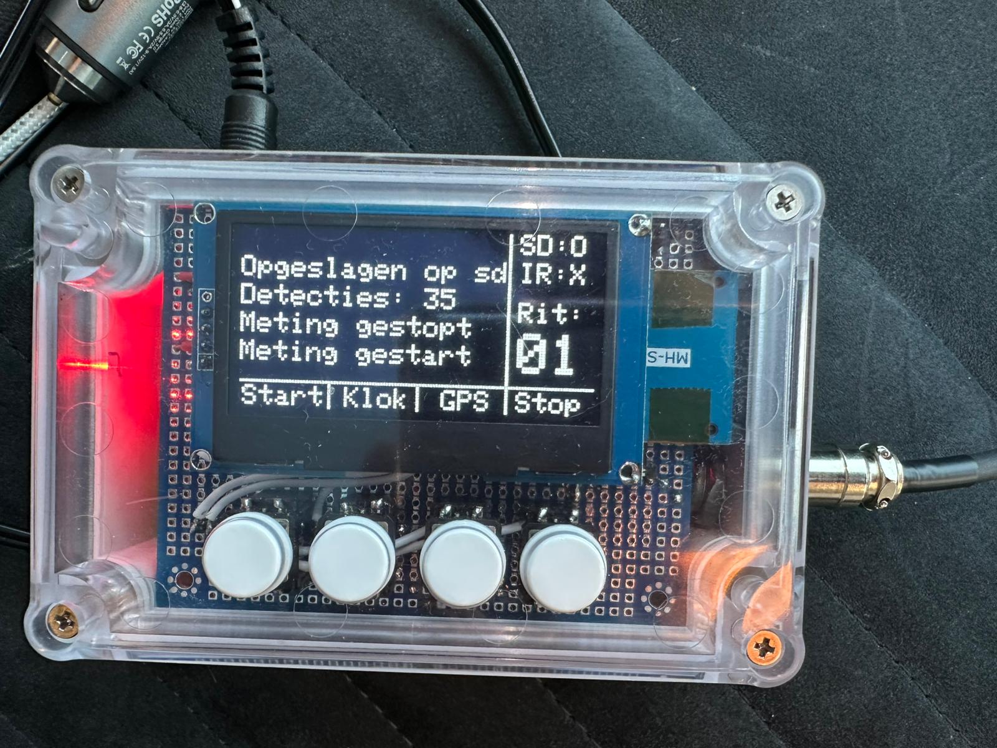
DoxyWizard/html/LogiTrack_MR1.jpg
