rielvanm/VRI_Datalogger_/Op te ruimen/Temp/klok.jpg

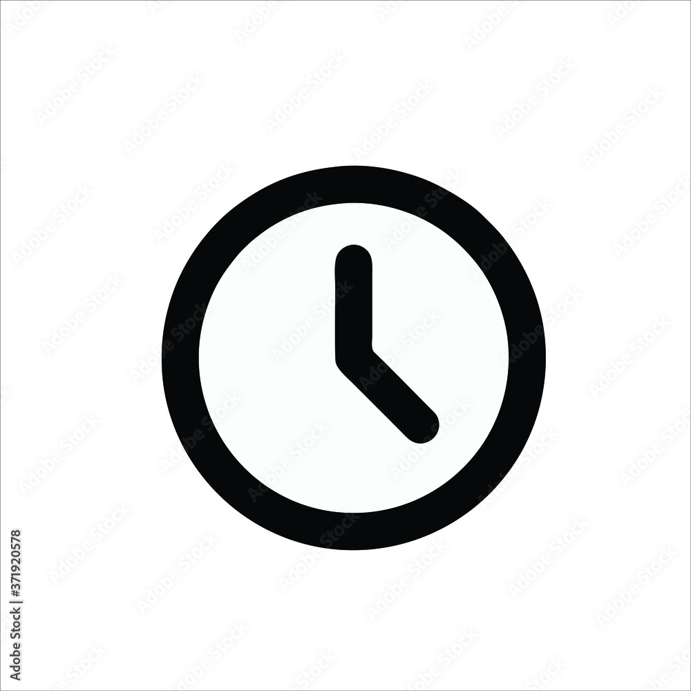
Op te ruimen/Temp/klok.jpg
