rielvanm/VRI_Datalogger_/Op te ruimen/Temp/Politie.jpg

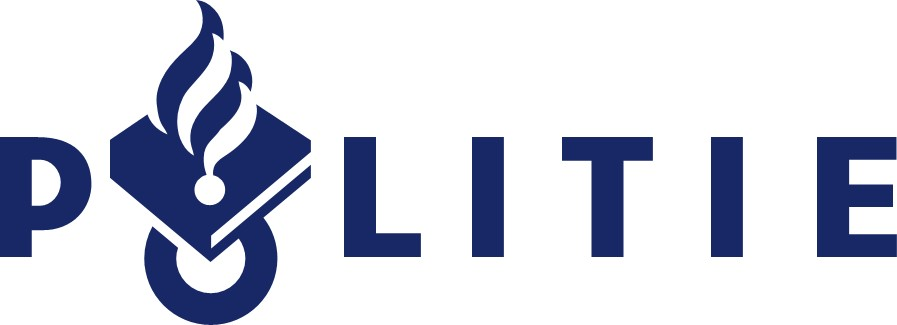
Op te ruimen/Temp/Politie.jpg
