rielvanm/VRI_Datalogger_/Plan van Aanpak/Interface.jpg

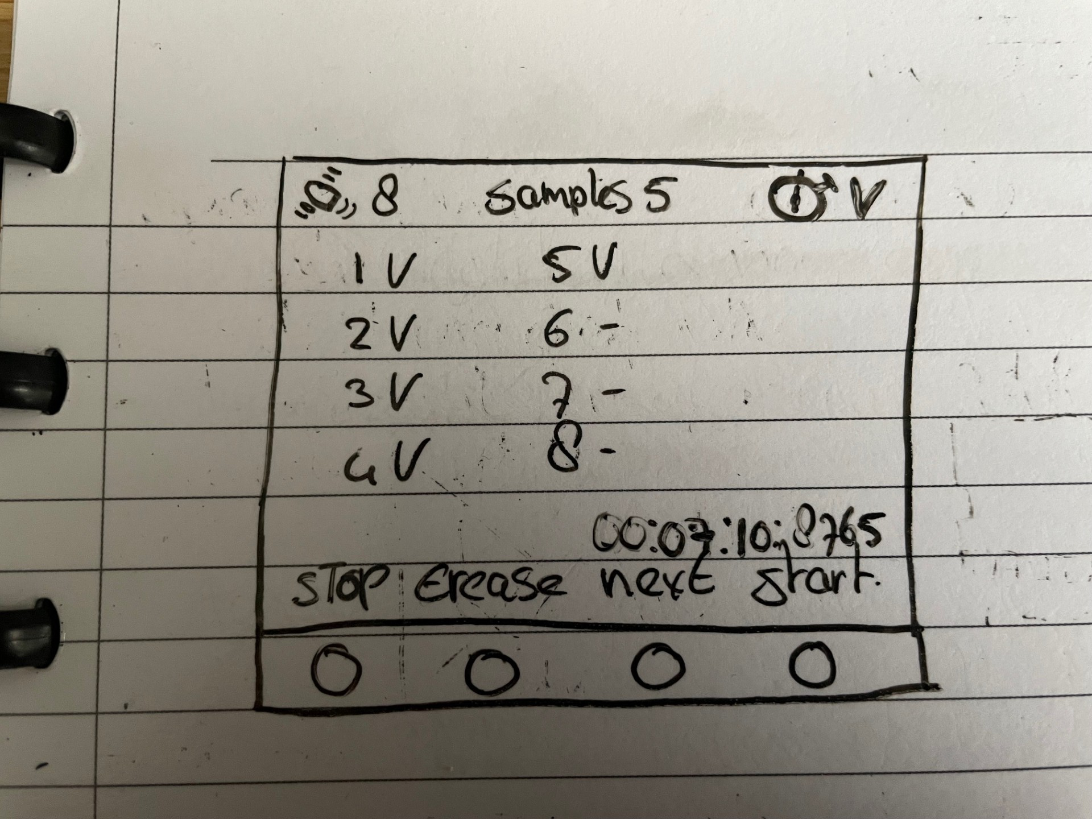
Plan van Aanpak/Interface.jpg
