rielvanm/VRI_Datalogger_/Productdocument/Bijlage/Ilustraties/Grote_Omloop.jpg

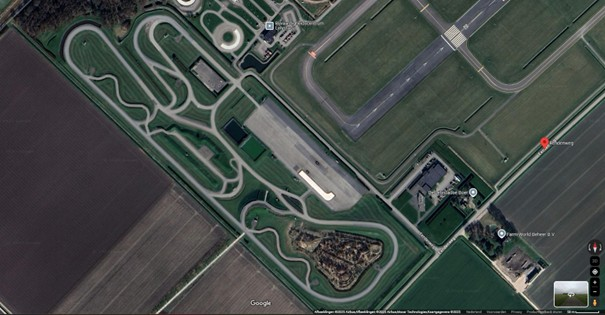
Productdocument/Bijlage/Ilustraties/Grote_Omloop.jpg
