rielvanm/VRI_Datalogger_/Productdocument/Bijlage/Ilustraties/Lelystad.jpg

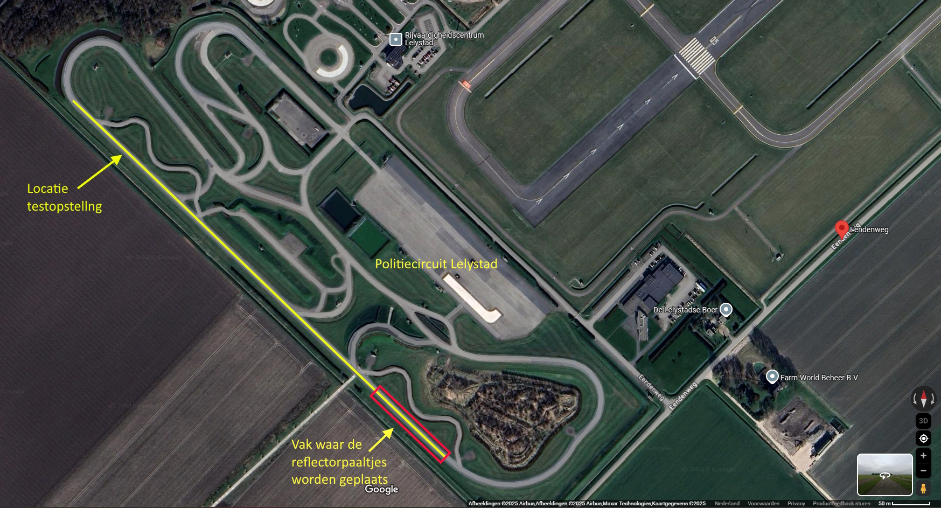
Productdocument/Bijlage/Ilustraties/Lelystad.jpg
