rielvanm/VRI_Datalogger_/Productdocument/Bijlage/Ilustraties/SD reader.jpg

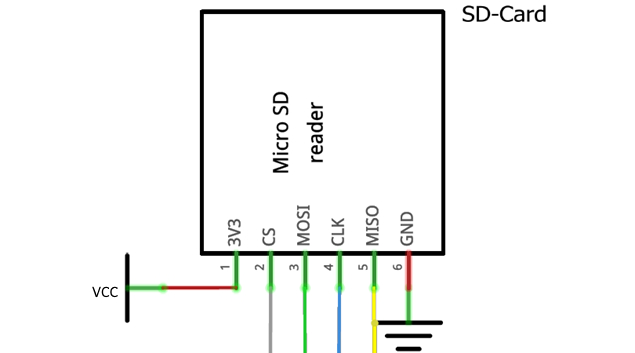
Productdocument/Bijlage/Ilustraties/SD reader.jpg
