rielvanm/VRI_Datalogger_/Productdocument/Bijlage/Ilustraties/Set_LogiTrack.jpg

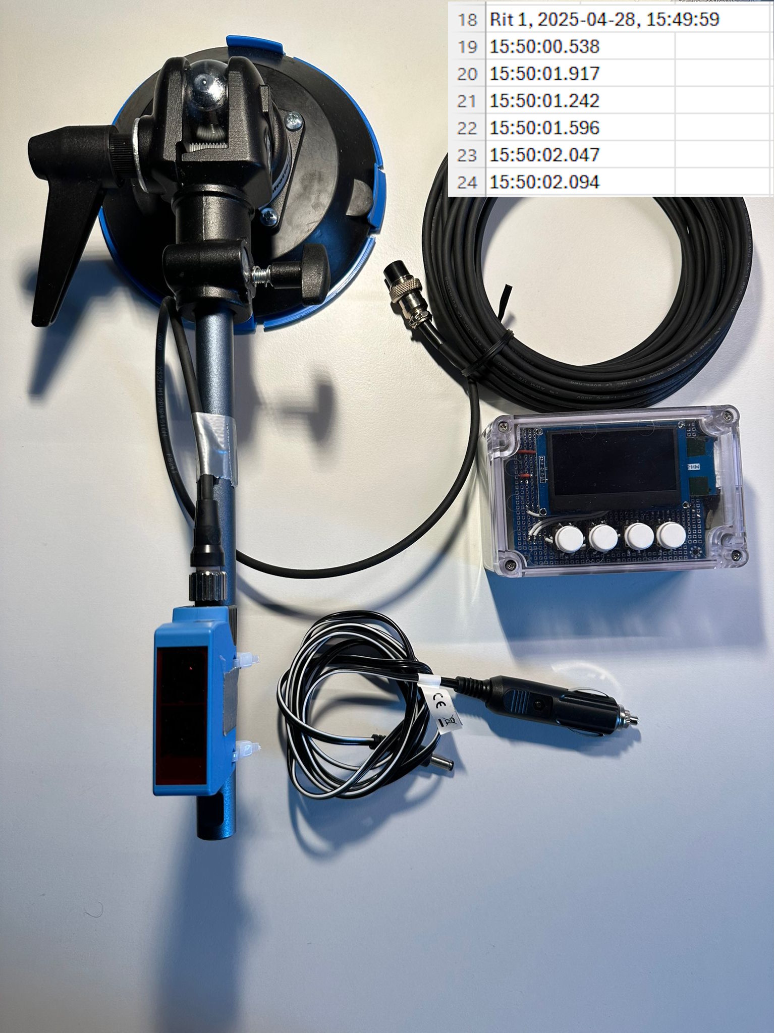
Productdocument/Bijlage/Ilustraties/Set_LogiTrack.jpg
