rielvanm/VRI_Datalogger_/Productdocument/Bijlage/Ilustraties/SICK_spanning_deler.jpg

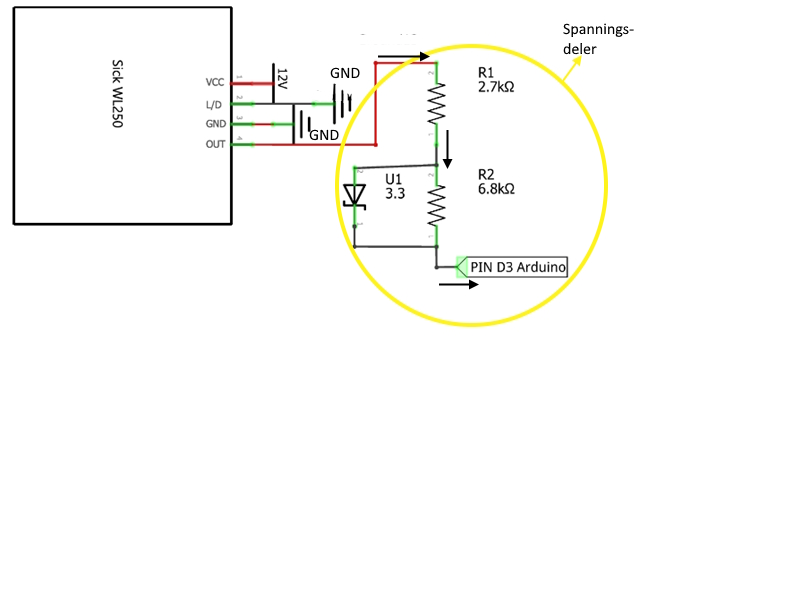
Productdocument/Bijlage/Ilustraties/SICK_spanning_deler.jpg
