rielvanm/VRI_Datalogger_/Productdocument/Bijlage/UML Activity diagram/event_driven.png

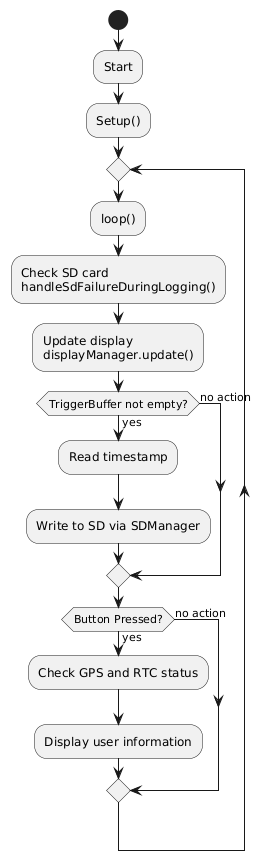
Productdocument/Bijlage/UML Activity diagram/event_driven.png
