rielvanm/VRI_Datalogger_/Productdocument/Bijlage/UML Activity diagram/interrupt.png

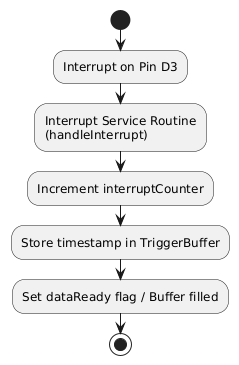
Productdocument/Bijlage/UML Activity diagram/interrupt.png
