rielvanm/VRI_Datalogger_/Tussentijdse_rapportage/5 april2.jpg

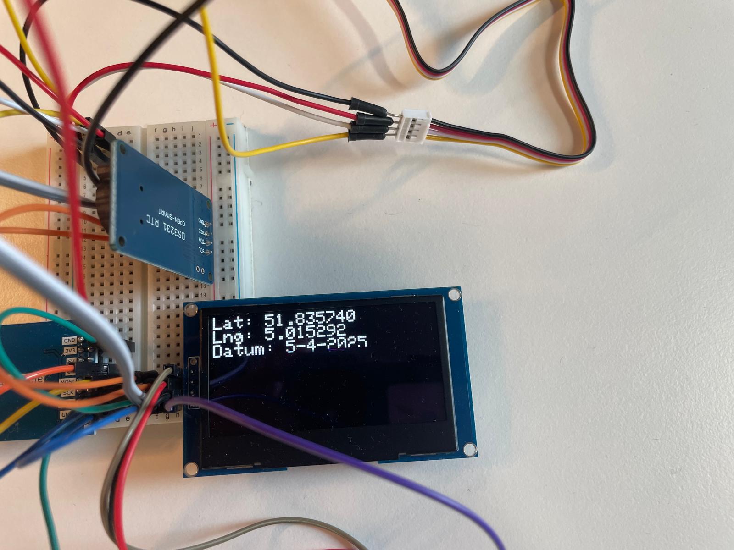
Tussentijdse_rapportage/5 april2.jpg
