rielvanm/VRI_Datalogger_/Tussentijdse_rapportage/5 april3.jpg

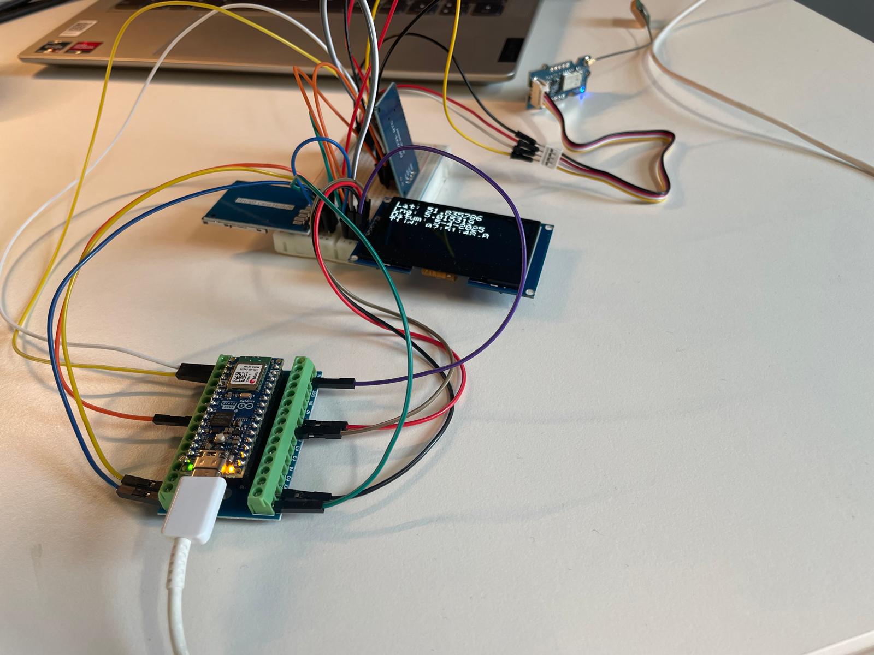
Tussentijdse_rapportage/5 april3.jpg
