rielvanm/VRI_Datalogger_/Tussentijdse_rapportage/5 april.jpg

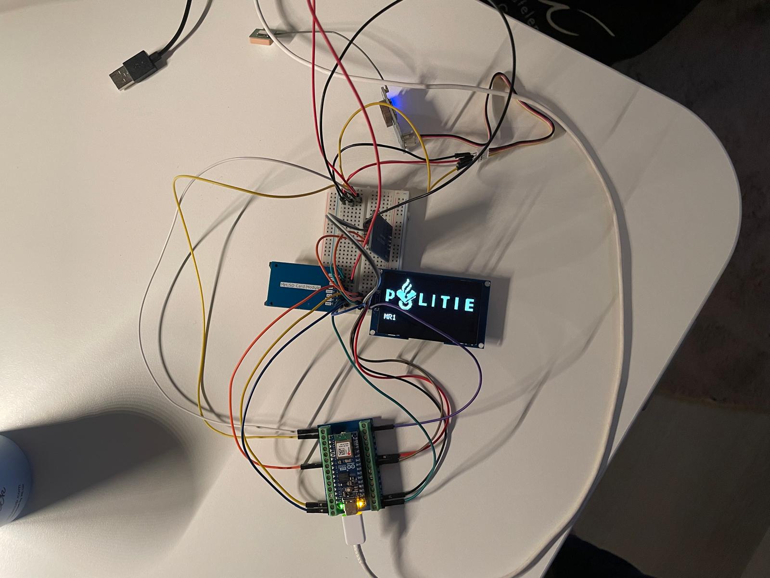
Tussentijdse_rapportage/5 april.jpg
