rielvanm/VRI_Datalogger_/Tussentijdse_rapportage/iCloud‑foto’s/iCloud‑foto’s/IMG_2982.JPEG

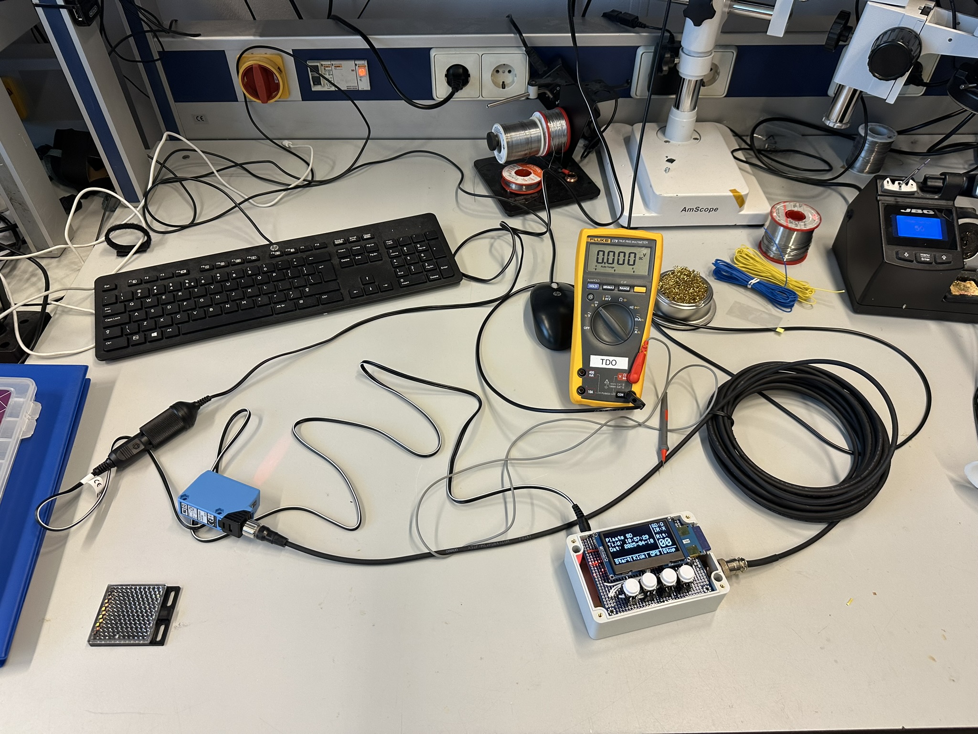
Tussentijdse_rapportage/iCloud‑foto’s/iCloud‑foto’s/IMG_2982.JPEG
