rielvanm/VRI_Datalogger_/Testen/Testdag/DAQ/Test/test1.txt

Data Translation Filewriter V1.0.0.20113 copyright 2012 Data Translation GmbH

Description:

Measured Time [Sec]:
36,3657
1,4128
1,3508
1,2867
