rielvanm/VRI_Datalogger_/Testen/Testdag/DAQ/Test/test3.txt

Data Translation Filewriter V1.0.0.20113 copyright 2012 Data Translation GmbH

Description:

Measured Time [Sec]:
27,8913
1,0681
1,0252
