rielvanm/VRI_Datalogger_/Testen/Testdag/DAQ/Test1/Test1.txt

Data Translation Filewriter V1.0.0.20113 copyright 2012 Data Translation GmbH

Description:

Measured Time [Sec]:
21,7786
0,1025
0,1028
0,1013
