rielvanm/VRI_Datalogger_/Testen/Testdag/DAQ/Test1/Test2.txt

Data Translation Filewriter V1.0.0.20113 copyright 2012 Data Translation GmbH

Description:

Measured Time [Sec]:
16,1817
0,0828
0,083
0,0818
