rielvanm/VRI_Datalogger_/Testen/Testdag/DAQ/Test1/Test3.txt

Data Translation Filewriter V1.0.0.20113 copyright 2012 Data Translation GmbH

Description:

Measured Time [Sec]:
16,0326
0,0687
0,0688
0,0679
