rielvanm/VRI_Datalogger_/Testen/Testdag/DAQ/Test1/Test5.txt

Data Translation Filewriter V1.0.0.20113 copyright 2012 Data Translation GmbH

Description:

Measured Time [Sec]:
14,6096
0,053
0,053
0,0524
