rielvanm/VRI_Datalogger_/Testen/Testdag/DAQ/Test10/test1.txt

Data Translation Filewriter V1.0.0.20113 copyright 2012 Data Translation GmbH

Description:

Measured Time [Sec]:
28,0869
1,0058
1,0003
1,0003
