rielvanm/VRI_Datalogger_/Testen/Testdag/DAQ/Test10/test2.txt

Data Translation Filewriter V1.0.0.20113 copyright 2012 Data Translation GmbH

Description:

Measured Time [Sec]:
25,7099
0,8069
0,8021
0,802
