rielvanm/VRI_Datalogger_/Testen/Testdag/DAQ/Test10/test3.txt

Data Translation Filewriter V1.0.0.20113 copyright 2012 Data Translation GmbH

Description:

Measured Time [Sec]:
21,1441
0,6796
0,6744
0,673
