rielvanm/VRI_Datalogger_/Testen/Testdag/DAQ/Test10/test4.txt

Data Translation Filewriter V1.0.0.20113 copyright 2012 Data Translation GmbH

Description:

Measured Time [Sec]:
20,5154
0,5824
0,5793
0,579
