rielvanm/VRI_Datalogger_/Testen/Testdag/DAQ/Test10/test5.txt

Data Translation Filewriter V1.0.0.20113 copyright 2012 Data Translation GmbH

Description:

Measured Time [Sec]:
39,0451
0,5196
0,5156
0,5142
