rielvanm/VRI_Datalogger_/Testen/Testdag/DAQ/Test15/Test1.txt

Data Translation Filewriter V1.0.0.20113 copyright 2012 Data Translation GmbH

Description:

Measured Time [Sec]:
34,4024
1,5301
1,5248
