rielvanm/VRI_Datalogger_/Testen/Testdag/DAQ/Test15/Test3.txt

Data Translation Filewriter V1.0.0.20113 copyright 2012 Data Translation GmbH

Description:

Measured Time [Sec]:
21,3617
1,0156
1,009
0,9595
