rielvanm/VRI_Datalogger_/Testen/Testdag/DAQ/Test15/Test5.txt

Data Translation Filewriter V1.0.0.20113 copyright 2012 Data Translation GmbH

Description:

Measured Time [Sec]:
26,2482
0,7723
0,7689
0,7315
