rielvanm/VRI_Datalogger_/Testen/Testdag/DAQ/Test5/Test1.txt

Data Translation Filewriter V1.0.0.20113 copyright 2012 Data Translation GmbH

Description:

Measured Time [Sec]:
23,1091
0,5073
0,505
0,5736
