rielvanm/VRI_Datalogger_/Testen/Testdag/DAQ/Test5/Test3.txt

Data Translation Filewriter V1.0.0.20113 copyright 2012 Data Translation GmbH

Description:

Measured Time [Sec]:
16,9634
0,3397
0,3385
0,3845
