rielvanm/VRI_Datalogger_/Testen/Testdag/DAQ/Test5/Test4.txt

Data Translation Filewriter V1.0.0.20113 copyright 2012 Data Translation GmbH

Description:

Measured Time [Sec]:
20,1445
0,2938
0,2927
0,3327
