rielvanm/VRI_Datalogger_/Testen/Testdag/DAQ/Test5/Test5.txt

Data Translation Filewriter V1.0.0.20113 copyright 2012 Data Translation GmbH

Description:

Measured Time [Sec]:
40,6776
0,2591
0,2582
0,2931
