rielvanm/VRI_Datalogger_/Testen/Testdag/DAQ/Test_Extra/test1.txt

Data Translation Filewriter V1.0.0.20113 copyright 2012 Data Translation GmbH

Description:

Measured Time [Sec]:
11,4736
0,0394
0,0394
0,0387
