rielvanm/VRI_Datalogger_/Testen/Testdag/DAQ/Test_Extra/test2.txt

Data Translation Filewriter V1.0.0.20113 copyright 2012 Data Translation GmbH

Description:

Measured Time [Sec]:
36,2477
0,0412
0,0412
0,0406
