rielvanm/VRI_Datalogger_/Testen/Testdag/DAQ/Test_Extra/test3.txt

Data Translation Filewriter V1.0.0.20113 copyright 2012 Data Translation GmbH

Description:

Measured Time [Sec]:
17,8902
0,1273
0,1286
0,1267
