rielvanm/VRI_Datalogger_/Testen/Testdag/DAQ/Test_Extra/test4.txt

Data Translation Filewriter V1.0.0.20113 copyright 2012 Data Translation GmbH

Description:

Measured Time [Sec]:
23,1131
0,1063
0,1067
0,1043
