rielvanm/VRI_Datalogger_/Testen/Test formulier.docx

Test 1 (Reflectie op 20 meter van elkaar)

Test | Tijd start | Tijd stop | Bijzonderheden
Rit 1 -> 40 km/h
Rit 2 -> 50 km/h
Rit 3 -> 60 km/h
Rit 4 -> 70 km/h
Rit 5 -> 80 km/h

Test 2 (Reflectie op 15 meter van elkaar)

Test | Tijd start | Tijd stop | Bijzonderheden
Rit 1 -> 40 km/h
Rit 2 -> 50 km/h
Rit 3 -> 60 km/h
Rit 4 -> 70 km/h
Rit 5 -> 80 km/h

Test 3 (Reflectie op 10 meter van elkaar)

Test | Tijd start | Tijd stop | Bijzonderheden
Rit 1 -> 40 km/h
Rit 2 -> 50 km/h
Rit 3 -> 60 km/h
Rit 4 -> 70 km/h
Rit 5 -> 80 km/h

Test 4 (Reflectie op 5 meter van elkaar)

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

Test 5 (Reflectie op 1 meter van elkaar)

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

Test 6 (Reflectie op meter van elkaar)

Test | Tijd start | Tijd stop | Bijzonderheden
Rit 1 -> km/h
Rit 2 -> km/h
Rit 3 -> km/h
Rit 4 -> km/h
Rit 5 -> km/h

Test 7 (Reflectie op meter van elkaar)

Test | Tijd start | Tijd stop | Bijzonderheden
Rit 1 -> km/h
Rit 2 -> km/h
Rit 3 -> km/h
Rit 4 -> km/h
Rit 5 -> km/h

Test 8 (Reflectie op meter van elkaar)

Test | Tijd start | Tijd stop | Bijzonderheden
Rit 1 -> km/h
Rit 2 -> km/h
Rit 3 -> km/h
Rit 4 -> km/h
Rit 5 -> km/h

Test 9 (Reflectie op meter van elkaar)

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

Test 6 (Reflectie op meter van elkaar)

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
