rielvanm/VRI_Datalogger_/Testen/Testdag/Notities.pdf

to 8
0}

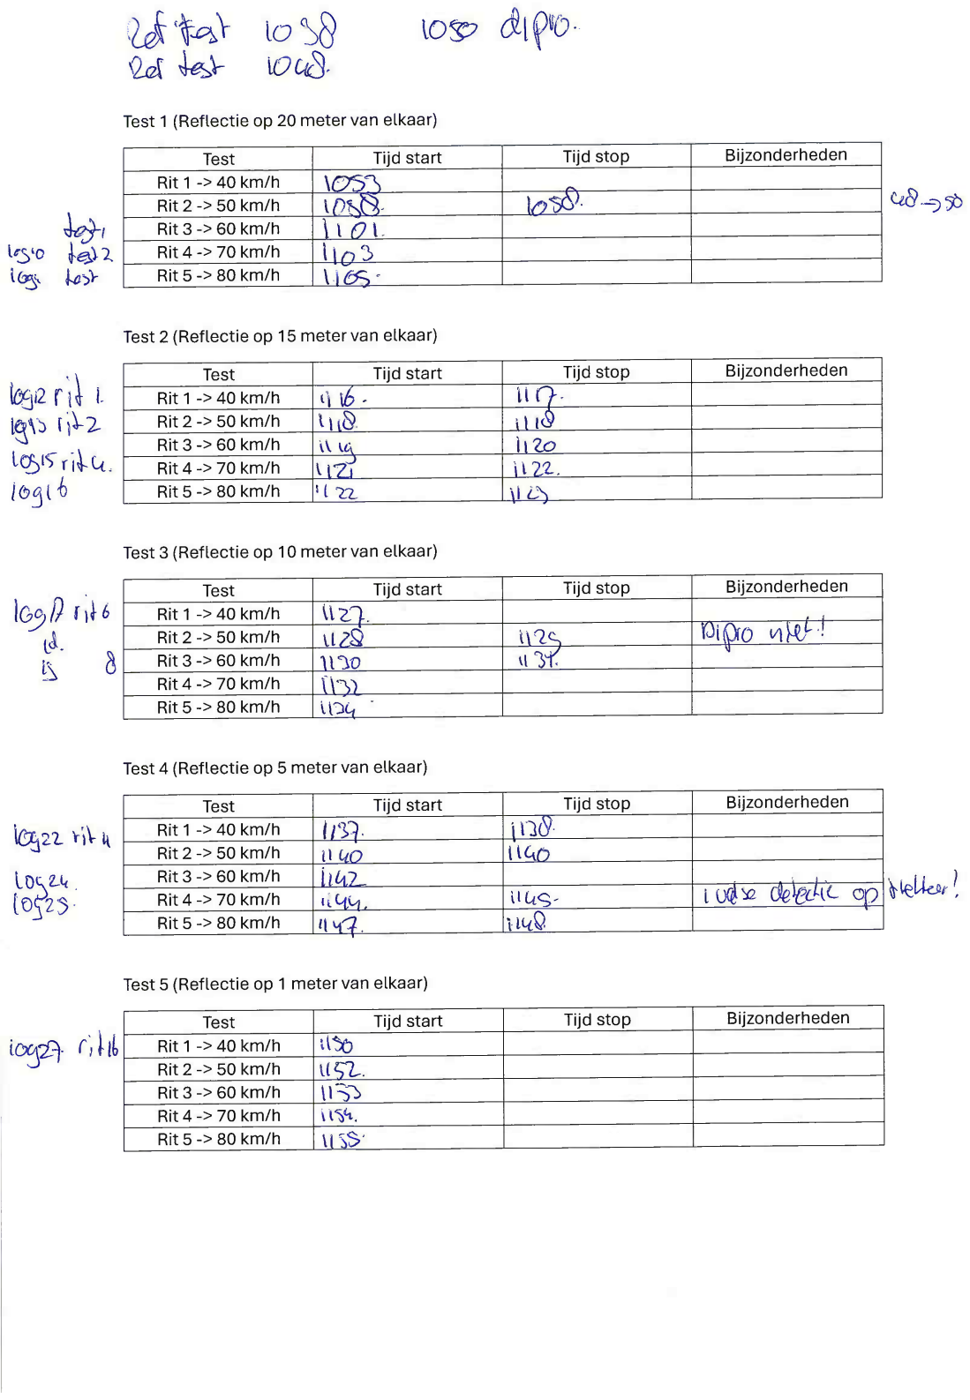
[picture p85: page 1]

Test 1 (Reflectie op 20 meter van elkaar)

Test | Tijd start | Tijd stop | Bijzonderheden

## LBit2-?@O km/h p'Po? I

Rit 1 -> 40 km/h
C}3) do Rit3->60km/h

ka

ka
k

# }Bit4-?70Km/h 'lII

Rit5 -> 80km/h

Test 2 (Reflectie op 15 meter van elkaar)

# epo rilt

q à2

## 105ril

to4

Test | Tijd start | Tijd stop | Bijzonderheden
Rit 1 -> 40 km/h | 4tb- | u}
Rit 2 -> 50 km/h | u | 1
Rit 3 -> 60 km/h | ( | h1o
Rit 4-> 70km/h | u7 | 122.
Rit 5 -> 80 km/h | 't22 | l

Test 3 (Reflectie op 1 0 meter van elkaar)

Test | Tijd start | Tijd stop | Bijzonderheden
Rit 1 -> 40 km/h | l22
Rit 2 -> 50 km/h | u2g | 02e, | Oio
'! Rit 3 -> 60 km/h | 1110 | tv 3f
| | | V
Rit 4 -> 70 km/h | fl»
Rit 5 -> 80 km/h

,

Test 4 (Reflectie op 5 meter van elkaar)

Test | Tijd start | Tijd stop | Bijzonderheden
~2'2.. r'i\. ~ f---Ri_t _1 _->_4_0_k_m_/_h_--+-'-'--""-+'------++~"------ | ----+---------
Rit 2 -> 50 km/h
0<Z«. | Rit3->60km/h_
(os | 'éiá=ij4 i!!'falaa. a, '

## ella'

Rit 5->80km/h | 'ué?

Test 5 (Reflectie op 1 meter van elkaar)

Test | Tijd start | Tijd stop | Bijzonderheden
Rit 1 -> 40 km/h | u0
Rit 2 -> 50 km/h | u52.
Rit 3 -> 60 km/h | 153
Rit 4 -> 70 km/h | 64.
Rit 5 -> 80 km/h | u3>

## tol

## col

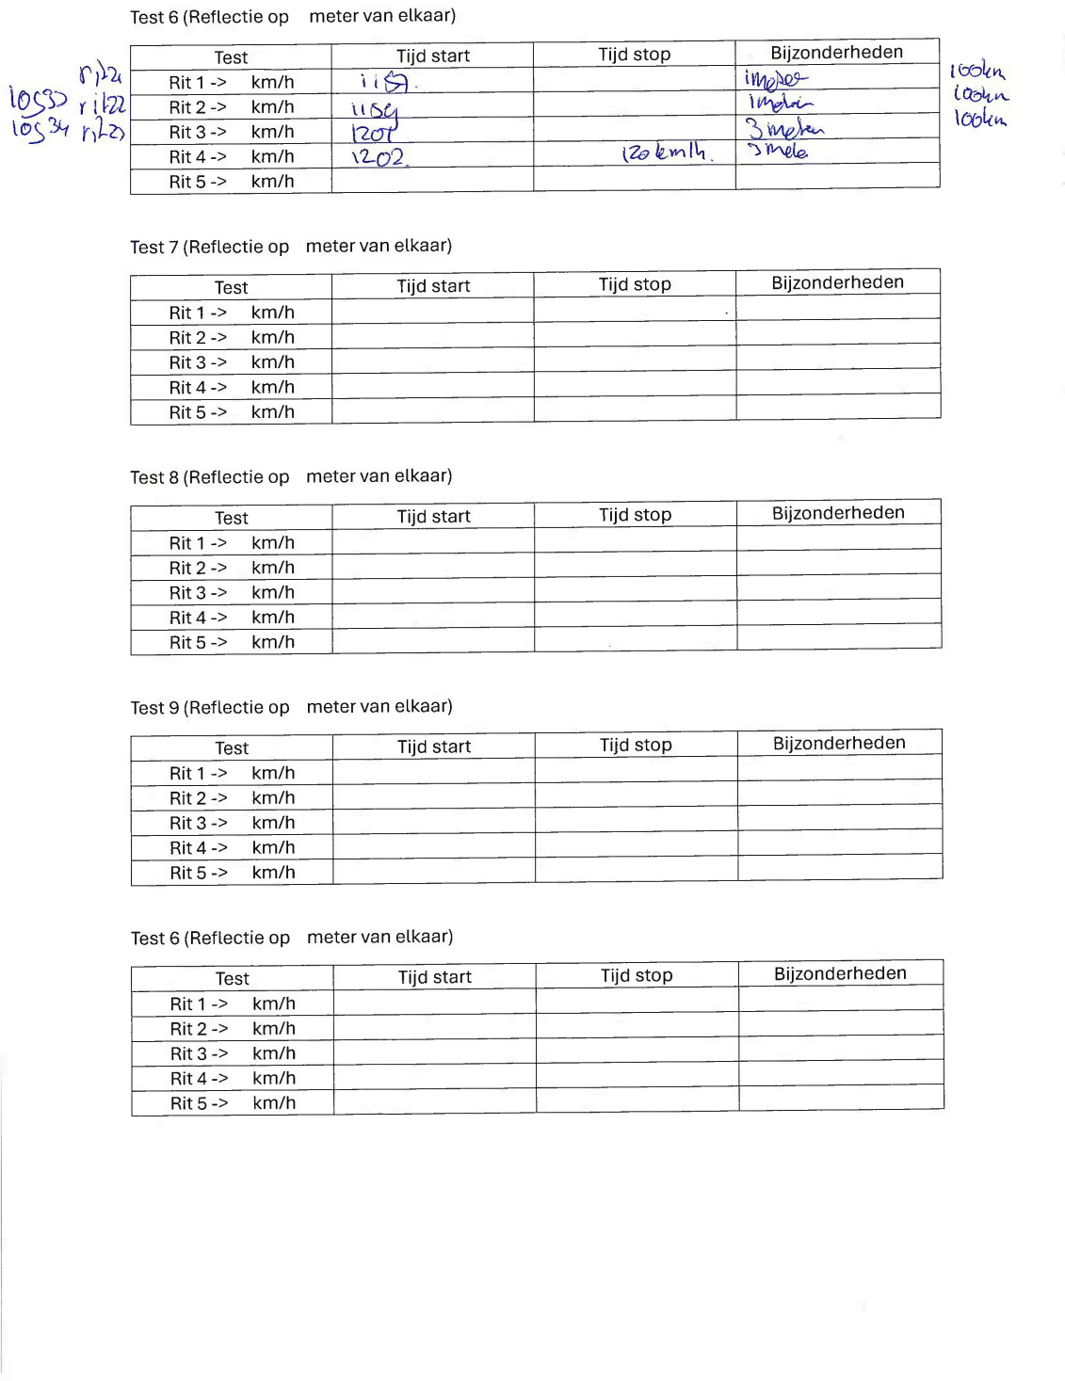
[picture p86: page 2]

Test 6 (Reflectie op meter van elkaar)

Test | Tijd start | Tijd stop | Bijzonderheden
Rit 1-> | km/h | i\. | itoNo
Rit 2-> | km/h | ((5 | \o-
Rit 3-> | km/h | 2or' | 3 wok
Rit 4-> | km/h | 202.
(zo vl. | rel
Rit 5-> | km/h

Test 7 (Reflectie op meter van elkaar)

Test | Tijd start | Tijd stop | Bijzonderheden
Rit 1-> | km/h
Rit 2-> | km/h
Rit 3-> | km/h
Rit 4-> | km/h
Rit 5-> | km/h

Test 8 (Reflectie op meter van elkaar)

Test | Tijd start | Tijd stop | Bijzonderheden
Rit 1-> | km/h
Rit 2-> | km/h
Rit 3-> | km/h
Rit 4-> | km/h
Rit 5-> | km/h

Test 9 (Reflectie op meter van elkaar)

Test | Tijd start | Tijd stop | Bijzonderheden
Rit 1-> | km/h
Rit 2-> | km/h
Rit 3-> | km/h
Rit 4-> | km/h
Rit 5-> | km/h

Test 6 (Reflectie op meter van elkaar)

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

## lol
