rielvanm/VRI_Datalogger_/Plan van Aanpak/Onderzoek/Validatie.xlsx

Sheet: Blad1
Titel | Lusnummers D05.6 - D05,4 |  |  |  | Lusnummers D05.4 - D05.2 |  |  | Gehele traject
 | Logbestand | Meting |  | Verschil | Logbestand | Meting | Verschil | Logbestand | Meting | Verschil
Rijproef 1 | 0.7000 | 0.6940 |  | -0.0060 | 1.3000 | 1.2367 | -0.0633 | 2.0000 | 1.9307 | -0.0693
Rijproef 2 | 0.4000 | 0.4792 |  | 0.0792 | 0.9000 | 0.8547 | -0.0453 | 1.3000 | 1.3339 | 0.0339
Rijproef 3 | 0.5000 | 0.5207 |  | 0.0207 | 1.1000 | 1.1101 | 0.0101 | 1.6000 | 1.6308 | 0.0308
Rijproef 4 | 0.5000 | 0.4346 |  | -0.0654 | 0.7000 | 0.7792 | 0.0792 | 1.2000 | 1.2138 | 0.0138
Rijproef 5 | 0.5000 | 0.5649 |  | 0.0649 | 1.1000 | 1.0087 | -0.0913 | 1.6000 | 1.5736 | -0.0264
Rijproef 6 | 0.4000 | 0.4003 |  | 0.0003 | 0.7000 | 0.7180 | 0.0180 | 1.1000 | 1.1183 | 0.0183
Rijproef 7 | 0.5000 | 0.5043 |  | 0.0043 | 1.0000 | 0.9007 | -0.0993 | 1.5000 | 1.4050 | -0.0950
Rijproef 8 | 0.4000 | 0.4156 |  | 0.0156 | 0.7000 | 0.7431 | 0.0431 | 1.1000 | 1.1587 | 0.0587
Rijproef 9 | 0.6000 |  |  |  | 0.7000 |  |  | 1.3000
Rijproef 10 | 0.3000 | 0.4050 |  | 0.1050 | 0.8000 | 0.7250 | -0.0750 | 1.1000 | 1.1300 | 0.0300
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
