rielvanm/VRI_Datalogger_/Testen/Testdag/LogiTrack/uitwerking.xlsx

Sheet: LogiTrack_all
Rit 1, 2025-05-09, 11:16:17 15M | LogiTrack | DAQ | Verschil
11:16:47.703
11:16:49.224 | 1.521 | 1.5301 | -0.0091
11:16:50.757 | 1.533 | 1.5248 | 0.0082
11:16:52.212
Rit 2, 2025-05-09, 11:18:06
11:18:32.348
11:18:33.578 | 2.23 | 1.2137 | 1.0163
11:18:34.775 | 1.197 | 1.2081 | -0.0111
11:18:35.926 | 1.151 | 1.148 | 0.003
Rit 3, 2025-05-09, 11:19:50
11:20:09.133
11:20:10.139 | 1.006 | 1.0156 | -0.0096
11:20:11.157 | 1.018 | 1.009 | 0.009
11:20:12.108 | 0.951 | 0.9595 | -0.0085
Rit 4, 2025-05-09, 11:21:41
11:22:01.011
11:22:02.896 | 1.885 | 0.8709 | 1.0141
11:22:03.748 | 0.852 | 0.8679 | -0.0159
11:22:04.580 | 0.8 | 0.8259 | -0.0259
Rit 5, 2025-05-09, 11:23:27
11:23:43.784
11:23:44.551 | 0.767 | 0.7723 | -0.0053
11:23:45.330 | 0.779 | 0.7689 | 0.0101
11:23:46.055 | 0.725 | 0.7315 | -0.0065
11:24:29.412
Rit 6, 2025-05-09, 11:26:58 bij 10M
11:27:22.738
11:27:23.743 | 1.005 | 1.0058 | -0.0008
11:27:24.761 | 1.018 | 1.0003 | 0.0177
11:27:25.748 | 0.987 | 1.0003 | -0.0133
Rit 7, 2025-05-09, 11:28:48
11:29:10.822
11:29:10.628 |  | 0.8069
11:29:11.432 | 0.804 | 0.8021 | 0.0019
11:29:12.231 | 0.799 | 0.802 | -0.003
Rit 8, 2025-05-09, 11:30:35
11:30:51.517
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
