rielvanm/VRI_Datalogger_/Testen/Testdag/Mov1Log/oud/RT040330/006_22306_300304_075008.CSV

FILE NAME | 006_22306_300304_075008.CSV
HASHCODE | C06E331AB2A1F81C004361255269202D7DC165AABE64AC30F917FB925FD18FA5
GYRO CAL | -0,000 | 0,884 | 0,013 | -0,862
ACCEL LONG CAL | 1,002 | -0,057
ACCEL LAT CAL | 1,012 | 0,040
ACCEL VERT CAL | 1,003 | -0,003
START OF MEASUREMENT | 30/03/2004 | 07:50:08 | GMT+00:00
END OF MEASUREMENT | 30/03/2004 | 07:50:27 | GMT+00:00
STANDARD CONFIG | LOGGER AND DISPLAY NON-STANDARD
ERROR DURING TEST | NO ERRORS
UNIT SERIAL | 22306
TOTAL TIME | 18790 | [mS]
TIME GPS SPEED WENT OVER 2KPH | 8580 | [mS]
TIME GPS SPEED WENT UNDER 2KPH | 15980 | [mS]
PEAK GPS SPEED | 27,76 | [kph]
TIME OF PEAK GPS SPEED | 12370 | [mS]
PEAK SPEED | 28,80 | [kph]
TIME OF PEAK SPEED | 12270 | [mS]
TIME ACC WENT OVER 1m/s/s | 12350 | [mS]
PEAK ACC | 3,28 | [m/s/s]
TIME OF PEAK ACC | 10710 | [mS]
PEAK PITCH | 1,59 | [deg]
TIME OF PEAK PITCH | 13590 | [mS]
PEAK SLIP | 9,55 | [deg]
TIME OF PEAK SLIP | 13380 | [mS]
AVERAGE LONG ACCEL AT START | -0,20 | [m/s/s]
AVERAGE LAT ACCEL AT START | 0,07 | [m/s/s]
AVERAGE VERT ACCEL AT START | 9,85 | [m/s/s]
AVERAGE PITCH RATE AT START | 0,34 | [deg/s]
AVERAGE LONG ACCEL AT END | -0,17 | [m/s/s]
AVERAGE LAT ACCEL AT END | 0,03 | [m/s/s]
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
