rielvanm/VRI_Datalogger_/Testen/Testdag/Mov1Log/oud/RT040330/007_22306_300304_075109.CSV

FILE NAME | 007_22306_300304_075109.CSV
HASHCODE | C3E8861AD302E5EA2A1CF3981BC3183514EC76F0B216E35C57F6A35234512FAE
GYRO CAL | -0,000 | 0,884 | 0,013 | -0,862
ACCEL LONG CAL | 1,002 | -0,057
ACCEL LAT CAL | 1,012 | 0,040
ACCEL VERT CAL | 1,003 | -0,003
START OF MEASUREMENT | 30/03/2004 | 07:51:09 | GMT+00:00
END OF MEASUREMENT | 30/03/2004 | 07:51:25 | GMT+00:00
STANDARD CONFIG | LOGGER AND DISPLAY NON-STANDARD
ERROR DURING TEST | NO ERRORS
UNIT SERIAL | 22306
TOTAL TIME | 15640 | [mS]
TIME GPS SPEED WENT OVER 2KPH | 5620 | [mS]
TIME GPS SPEED WENT UNDER 2KPH | 13800 | [mS]
PEAK GPS SPEED | 34,27 | [kph]
TIME OF PEAK GPS SPEED | 9210 | [mS]
PEAK SPEED | 35,47 | [kph]
TIME OF PEAK SPEED | 9100 | [mS]
TIME ACC WENT OVER 1m/s/s | 9040 | [mS]
PEAK ACC | 5,84 | [m/s/s]
TIME OF PEAK ACC | 11300 | [mS]
PEAK PITCH | 1,97 | [deg]
TIME OF PEAK PITCH | 15310 | [mS]
PEAK SLIP | 8,52 | [deg]
TIME OF PEAK SLIP | 11410 | [mS]
AVERAGE LONG ACCEL AT START | -0,21 | [m/s/s]
AVERAGE LAT ACCEL AT START | 0,05 | [m/s/s]
AVERAGE VERT ACCEL AT START | 9,85 | [m/s/s]
AVERAGE PITCH RATE AT START | 0,32 | [deg/s]
AVERAGE LONG ACCEL AT END | -0,12 | [m/s/s]
AVERAGE LAT ACCEL AT END | -0,14 | [m/s/s]
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
