rielvanm/VRI_Datalogger_/Testen/Testdag/Mov1Log/oud/RT040407/001_22306_070404_122312.CSV

FILE NAME | 001_22306_070404_122312.CSV
HASHCODE | 7797728E023E51E32A92D43459EBBDFDD452061509EA9706AB3F2B79952A069E
GYRO CAL | -0,000 | 0,884 | 0,013 | -0,862
ACCEL LONG CAL | 1,002 | -0,057
ACCEL LAT CAL | 1,012 | 0,040
ACCEL VERT CAL | 1,003 | -0,003
START OF MEASUREMENT | 07/04/2004 | 12:23:12 | GMT+00:00
END OF MEASUREMENT | 07/04/2004 | 12:23:40 | GMT+00:00
STANDARD CONFIG | LOGGER AND DISPLAY NON-STANDARD
ERROR DURING TEST | NO ERRORS
UNIT SERIAL | 22306
TOTAL TIME | 27850 | [mS]
TIME GPS SPEED WENT OVER 2KPH | 5240 | [mS]
TIME GPS SPEED WENT UNDER 2KPH | 24410 | [mS]
PEAK GPS SPEED | 50,47 | [kph]
TIME OF PEAK GPS SPEED | 17210 | [mS]
PEAK SPEED | 50,93 | [kph]
TIME OF PEAK SPEED | 16940 | [mS]
TIME ACC WENT OVER 1m/s/s | 13150 | [mS]
PEAK ACC | 3,23 | [m/s/s]
TIME OF PEAK ACC | 20390 | [mS]
PEAK PITCH | 1,96 | [deg]
TIME OF PEAK PITCH | 15350 | [mS]
PEAK SLIP | 178,72 | [deg]
TIME OF PEAK SLIP | 21200 | [mS]
AVERAGE LONG ACCEL AT START | -0,10 | [m/s/s]
AVERAGE LAT ACCEL AT START | -0,21 | [m/s/s]
AVERAGE VERT ACCEL AT START | 9,83 | [m/s/s]
AVERAGE PITCH RATE AT START | 0,33 | [deg/s]
AVERAGE LONG ACCEL AT END | -0,00 | [m/s/s]
AVERAGE LAT ACCEL AT END | -0,19 | [m/s/s]
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
