rielvanm/VRI_Datalogger_/Testen/Testdag/Mov1Log/oud/RT040407/002_22306_070404_122507.CSV

FILE NAME | 002_22306_070404_122507.CSV
HASHCODE | 7F9045F9C25BA2DC8E4B0C20702B85C217FC6FF12C42374A068B26AFE6000380
GYRO CAL | -0,000 | 0,884 | 0,013 | -0,862
ACCEL LONG CAL | 1,002 | -0,057
ACCEL LAT CAL | 1,012 | 0,040
ACCEL VERT CAL | 1,003 | -0,003
START OF MEASUREMENT | 07/04/2004 | 12:25:07 | GMT+00:00
END OF MEASUREMENT | 07/04/2004 | 12:25:46 | GMT+00:00
STANDARD CONFIG | LOGGER AND DISPLAY NON-STANDARD
ERROR DURING TEST | NO ERRORS
UNIT SERIAL | 22306
TOTAL TIME | 38520 | [mS]
TIME GPS SPEED WENT OVER 2KPH | 5670 | [mS]
TIME GPS SPEED WENT UNDER 2KPH | 35700 | [mS]
PEAK GPS SPEED | 67,86 | [kph]
TIME OF PEAK GPS SPEED | 17280 | [mS]
PEAK SPEED | 67,78 | [kph]
TIME OF PEAK SPEED | 16860 | [mS]
TIME ACC WENT OVER 1m/s/s | 17220 | [mS]
PEAK ACC | 4,55 | [m/s/s]
TIME OF PEAK ACC | 25380 | [mS]
PEAK PITCH | 2,12 | [deg]
TIME OF PEAK PITCH | 31310 | [mS]
PEAK SLIP | 178,88 | [deg]
TIME OF PEAK SLIP | 33270 | [mS]
AVERAGE LONG ACCEL AT START | -0,08 | [m/s/s]
AVERAGE LAT ACCEL AT START | -0,16 | [m/s/s]
AVERAGE VERT ACCEL AT START | 9,83 | [m/s/s]
AVERAGE PITCH RATE AT START | 0,32 | [deg/s]
AVERAGE LONG ACCEL AT END | -0,05 | [m/s/s]
AVERAGE LAT ACCEL AT END | -0,29 | [m/s/s]
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
