rielvanm/VRI_Datalogger_/Testen/Testdag/Mov1Log/oud/RT040407/003_22306_070404_122802.CSV

FILE NAME | 003_22306_070404_122802.CSV
HASHCODE | 9ED9C8D460C39499626BD909FE7966356C450BCD456D99DF12B80C3763C0019E
GYRO CAL | -0,000 | 0,884 | 0,013 | -0,862
ACCEL LONG CAL | 1,002 | -0,057
ACCEL LAT CAL | 1,012 | 0,040
ACCEL VERT CAL | 1,003 | -0,003
START OF MEASUREMENT | 07/04/2004 | 12:28:02 | GMT+00:00
END OF MEASUREMENT | 07/04/2004 | 12:28:39 | GMT+00:00
STANDARD CONFIG | LOGGER AND DISPLAY NON-STANDARD
ERROR DURING TEST | NO ERRORS
UNIT SERIAL | 22306
TOTAL TIME | 36900 | [mS]
TIME GPS SPEED WENT OVER 2KPH | 4240 | [mS]
TIME GPS SPEED WENT UNDER 2KPH | 33840 | [mS]
PEAK GPS SPEED | 72,00 | [kph]
TIME OF PEAK GPS SPEED | 26430 | [mS]
PEAK SPEED | 72,97 | [kph]
TIME OF PEAK SPEED | 26230 | [mS]
TIME ACC WENT OVER 1m/s/s | 15200 | [mS]
PEAK ACC | 4,73 | [m/s/s]
TIME OF PEAK ACC | 27800 | [mS]
PEAK PITCH | 2,03 | [deg]
TIME OF PEAK PITCH | 29370 | [mS]
PEAK SLIP | 178,32 | [deg]
TIME OF PEAK SLIP | 25040 | [mS]
AVERAGE LONG ACCEL AT START | -0,10 | [m/s/s]
AVERAGE LAT ACCEL AT START | -0,19 | [m/s/s]
AVERAGE VERT ACCEL AT START | 9,84 | [m/s/s]
AVERAGE PITCH RATE AT START | 0,33 | [deg/s]
AVERAGE LONG ACCEL AT END | -0,03 | [m/s/s]
AVERAGE LAT ACCEL AT END | -0,17 | [m/s/s]
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
