rielvanm/VRI_Datalogger_/Testen/Testdag/Mov1Log/oud/RT201104/006_22306_041120_125725.CSV

FILE NAME | 006_22306_041120_125725.CSV
HASHCODE | E664B4AF619C0FB9418046C350391353073ACF0D5C938535D535A8D8FE6B0C22
GYRO CAL | -0,000 | 0,884 | 0,013 | -0,862
ACCEL LONG CAL | 1,002 | -0,057
ACCEL LAT CAL | 1,012 | 0,040
ACCEL VERT CAL | 1,003 | -0,003
START OF MEASUREMENT | 04/11/2020 | 12:57:25 | GMT+00:00
END OF MEASUREMENT | 04/11/2020 | 13:00:01 | GMT+00:00
STANDARD CONFIG | STANDARD CONFIGS USED
ERROR DURING TEST | NOT LEVEL Y
UNIT SERIAL | 22306
TOTAL TIME | 155340 | [mS]
TIME GPS SPEED WENT OVER 2KPH | 8660 | [mS]
TIME GPS SPEED WENT UNDER 2KPH | 150260 | [mS]
PEAK GPS SPEED | 46,30 | [kph]
TIME OF PEAK GPS SPEED | 148250 | [mS]
PEAK SPEED | 46,51 | [kph]
TIME OF PEAK SPEED | 148090 | [mS]
TIME ACC WENT OVER 1m/s/s | 12580 | [mS]
PEAK ACC | 12,40 | [m/s/s]
TIME OF PEAK ACC | 149030 | [mS]
PEAK PITCH | 3,21 | [deg]
TIME OF PEAK PITCH | 29780 | [mS]
PEAK SLIP | 178,61 | [deg]
TIME OF PEAK SLIP | 44860 | [mS]
AVERAGE LONG ACCEL AT START | -0,14 | [m/s/s]
AVERAGE LAT ACCEL AT START | 0,54 | [m/s/s]
AVERAGE VERT ACCEL AT START | 9,82 | [m/s/s]
AVERAGE PITCH RATE AT START | -0,02 | [deg/s]
AVERAGE LONG ACCEL AT END | -0,29 | [m/s/s]
AVERAGE LAT ACCEL AT END | 0,19 | [m/s/s]
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
