rielvanm/VRI_Datalogger_/Testen/Testdag/Mov1Log/oud/RT210313/001_22306_130321_052336.CSV

FILE NAME | 001_22306_130321_052336.CSV
HASHCODE | D0EF69C20689DE97100BCD00C5CECCA04A44C522565F2E45DC237AA02E372C6D
GYRO CAL | -0,000 | 0,884 | 0,013 | -0,862
ACCEL LONG CAL | 1,002 | -0,057
ACCEL LAT CAL | 1,012 | 0,040
ACCEL VERT CAL | 1,003 | -0,003
START OF MEASUREMENT | 13/03/2021 | 05:23:36 | GMT+00:00
END OF MEASUREMENT | 13/03/2021 | 05:23:44 | GMT+00:00
STANDARD CONFIG | STANDARD CONFIGS USED
ERROR DURING TEST | NO ERRORS
UNIT SERIAL | 22306
TOTAL TIME | 7670 | [mS]
TIME GPS SPEED WENT OVER 2KPH |  | [mS]
TIME GPS SPEED WENT UNDER 2KPH |  | [mS]
PEAK GPS SPEED | 0,11 | [kph]
TIME OF PEAK GPS SPEED | 3640 | [mS]
PEAK SPEED | 0,00 | [kph]
TIME OF PEAK SPEED | 0 | [mS]
TIME ACC WENT OVER 1m/s/s |  | [mS]
PEAK ACC | 0,30 | [m/s/s]
TIME OF PEAK ACC | 7640 | [mS]
PEAK PITCH | 0,55 | [deg]
TIME OF PEAK PITCH | 7550 | [mS]
PEAK SLIP | 0,00 | [deg]
TIME OF PEAK SLIP | 0 | [mS]
AVERAGE LONG ACCEL AT START | 0,01 | [m/s/s]
AVERAGE LAT ACCEL AT START | -0,12 | [m/s/s]
AVERAGE VERT ACCEL AT START | 9,74 | [m/s/s]
AVERAGE PITCH RATE AT START | 0,12 | [deg/s]
AVERAGE LONG ACCEL AT END | 0,00 | [m/s/s]
AVERAGE LAT ACCEL AT END | -0,13 | [m/s/s]
AVERAGE VERT ACCEL AT END | 9,74 | [m/s/s]
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
