rielvanm/VRI_Datalogger_/Testen/Testdag/Mov1Log/oud/RT210313/002_22306_130321_053059.CSV

FILE NAME | 002_22306_130321_053059.CSV
HASHCODE | 169EB344F8D1FEE06A3BF14FDD1B100E4D850EBD9F64C01D70F7F4E1E4B04B95
GYRO CAL | -0,000 | 0,884 | 0,013 | -0,862
ACCEL LONG CAL | 1,002 | -0,057
ACCEL LAT CAL | 1,012 | 0,040
ACCEL VERT CAL | 1,003 | -0,003
START OF MEASUREMENT | 13/03/2021 | 05:30:59 | GMT+00:00
END OF MEASUREMENT | 13/03/2021 | 05:31:38 | GMT+00:00
STANDARD CONFIG | STANDARD CONFIGS USED
ERROR DURING TEST | NOT LEVEL X
UNIT SERIAL | 22306
TOTAL TIME | 56230 | [mS]
TIME GPS SPEED WENT OVER 2KPH | 200 | [mS]
TIME GPS SPEED WENT UNDER 2KPH | 53810 | [mS]
PEAK GPS SPEED | 58,21 | [kph]
TIME OF PEAK GPS SPEED | 23420 | [mS]
PEAK SPEED | 58,65 | [kph]
TIME OF PEAK SPEED | 23030 | [mS]
TIME ACC WENT OVER 1m/s/s | 2950 | [mS]
PEAK ACC | 4,32 | [m/s/s]
TIME OF PEAK ACC | 19630 | [mS]
PEAK PITCH | 2,90 | [deg]
TIME OF PEAK PITCH | 13680 | [mS]
PEAK SLIP | 175,89 | [deg]
TIME OF PEAK SLIP | 19020 | [mS]
AVERAGE LONG ACCEL AT START | 0,89 | [m/s/s]
AVERAGE LAT ACCEL AT START | 0,17 | [m/s/s]
AVERAGE VERT ACCEL AT START | 9,77 | [m/s/s]
AVERAGE PITCH RATE AT START | 0,02 | [deg/s]
AVERAGE LONG ACCEL AT END | -0,12 | [m/s/s]
AVERAGE LAT ACCEL AT END | -0,36 | [m/s/s]
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
