rielvanm/VRI_Datalogger_/Testen/Testdag/Mov1Log/oud/RT220527/002_22306_270522_091808.CSV

FILE NAME | 002_22306_270522_091808.CSV
HASHCODE | 7CC623AD35E7F824C56872E8BA4282F27C940095814B431DF699C57E1CBF4673
GYRO CAL | -0,000 | 0,884 | 0,013 | -0,862
ACCEL LONG CAL | 1,002 | -0,057
ACCEL LAT CAL | 1,012 | 0,040
ACCEL VERT CAL | 1,003 | -0,003
START OF MEASUREMENT | 27/05/2022 | 09:18:08 | GMT+00:00
END OF MEASUREMENT | 27/05/2022 | 09:18:19 | GMT+00:00
STANDARD CONFIG | LOGGER AND DISPLAY NON-STANDARD
ERROR DURING TEST | NOT LEVEL X | LOGGING STARTED WITHOUT GPS
UNIT SERIAL | 22306
TOTAL TIME | 10890 | [mS]
TIME GPS SPEED WENT OVER 2KPH |  | [mS]
TIME GPS SPEED WENT UNDER 2KPH |  | [mS]
PEAK GPS SPEED | 0,00 | [kph]
TIME OF PEAK GPS SPEED | 0 | [mS]
PEAK SPEED | 0,00 | [kph]
TIME OF PEAK SPEED | 0 | [mS]
TIME ACC WENT OVER 1m/s/s | 20 | [mS]
PEAK ACC | 10,09 | [m/s/s]
TIME OF PEAK ACC | 10290 | [mS]
PEAK PITCH | 0,00 | [deg]
TIME OF PEAK PITCH | 0 | [mS]
PEAK SLIP | 0,00 | [deg]
TIME OF PEAK SLIP | 0 | [mS]
AVERAGE LONG ACCEL AT START | -9,96 | [m/s/s]
AVERAGE LAT ACCEL AT START | -0,03 | [m/s/s]
AVERAGE VERT ACCEL AT START | -0,12 | [m/s/s]
AVERAGE PITCH RATE AT START | 0,26 | [deg/s]
AVERAGE LONG ACCEL AT END | -9,96 | [m/s/s]
AVERAGE LAT ACCEL AT END | -0,05 | [m/s/s]
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
