rielvanm/VRI_Datalogger_/Testen/Testdag/Mov1Log/oud/RT220601/001_22306_010622_113918.CSV

FILE NAME | 001_22306_010622_113918.CSV
HASHCODE | C18FC77A2550C5EFB323E10476F99F04F8EE1F11458E6B5536682E3AEF04D516
GYRO CAL | -0,000 | 0,884 | 0,013 | -0,862
ACCEL LONG CAL | 1,002 | -0,057
ACCEL LAT CAL | 1,012 | 0,040
ACCEL VERT CAL | 1,003 | -0,003
START OF MEASUREMENT | 01/06/2022 | 11:39:18 | GMT+00:00
END OF MEASUREMENT | 01/06/2022 | 11:39:29 | GMT+00:00
STANDARD CONFIG | LOGGER AND DISPLAY NON-STANDARD
ERROR DURING TEST | NOT LEVEL X | NOT LEVEL Y
UNIT SERIAL | 22306
TOTAL TIME | 10620 | [mS]
TIME GPS SPEED WENT OVER 2KPH |  | [mS]
TIME GPS SPEED WENT UNDER 2KPH |  | [mS]
PEAK GPS SPEED | 0,25 | [kph]
TIME OF PEAK GPS SPEED | 20 | [mS]
PEAK SPEED | 0,32 | [kph]
TIME OF PEAK SPEED | 20 | [mS]
TIME ACC WENT OVER 1m/s/s |  | [mS]
PEAK ACC | 0,56 | [m/s/s]
TIME OF PEAK ACC | 10530 | [mS]
PEAK PITCH | 2,21 | [deg]
TIME OF PEAK PITCH | 5760 | [mS]
PEAK SLIP | 0,00 | [deg]
TIME OF PEAK SLIP | 0 | [mS]
AVERAGE LONG ACCEL AT START | -0,37 | [m/s/s]
AVERAGE LAT ACCEL AT START | -0,62 | [m/s/s]
AVERAGE VERT ACCEL AT START | 9,76 | [m/s/s]
AVERAGE PITCH RATE AT START | 0,25 | [deg/s]
AVERAGE LONG ACCEL AT END | -0,36 | [m/s/s]
AVERAGE LAT ACCEL AT END | -0,62 | [m/s/s]
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
