rielvanm/VRI_Datalogger_/Testen/Testdag/Mov1Log/oud/RT220601/002_22306_010622_113942.CSV

FILE NAME | 002_22306_010622_113942.CSV
HASHCODE | 097B34981C06129DB91D71640D3B60ADC270ACF7FC87F8EC494657DB50804419
GYRO CAL | -0,000 | 0,884 | 0,013 | -0,862
ACCEL LONG CAL | 1,002 | -0,057
ACCEL LAT CAL | 1,012 | 0,040
ACCEL VERT CAL | 1,003 | -0,003
START OF MEASUREMENT | 01/06/2022 | 11:39:42 | GMT+00:00
END OF MEASUREMENT | 01/06/2022 | 11:40:10 | GMT+00:00
STANDARD CONFIG | LOGGER AND DISPLAY NON-STANDARD
ERROR DURING TEST | NOT LEVEL X | NOT LEVEL Y
UNIT SERIAL | 22306
TOTAL TIME | 27870 | [mS]
TIME GPS SPEED WENT OVER 2KPH | 10480 | [mS]
TIME GPS SPEED WENT UNDER 2KPH |  | [mS]
PEAK GPS SPEED | 92,74 | [kph]
TIME OF PEAK GPS SPEED | 18070 | [mS]
PEAK SPEED | 92,89 | [kph]
TIME OF PEAK SPEED | 17790 | [mS]
TIME ACC WENT OVER 1m/s/s | 17190 | [mS]
PEAK ACC | 10,04 | [m/s/s]
TIME OF PEAK ACC | 19690 | [mS]
PEAK PITCH | 3,28 | [deg]
TIME OF PEAK PITCH | 20330 | [mS]
PEAK SLIP | 15,74 | [deg]
TIME OF PEAK SLIP | 11470 | [mS]
AVERAGE LONG ACCEL AT START | -0,36 | [m/s/s]
AVERAGE LAT ACCEL AT START | -0,62 | [m/s/s]
AVERAGE VERT ACCEL AT START | 9,76 | [m/s/s]
AVERAGE PITCH RATE AT START | 0,27 | [deg/s]
AVERAGE LONG ACCEL AT END | -1,81 | [m/s/s]
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
