rielvanm/VRI_Datalogger_/Testen/Testdag/Mov1Log/oud/RT220601/003_22306_010622_114136.CSV

FILE NAME | 003_22306_010622_114136.CSV
HASHCODE | 5E10CFBC2ABAF3A3C8EADC0A72D5A51061A4DD5A115EF118A422A1BA536BF831
GYRO CAL | -0,000 | 0,884 | 0,013 | -0,862
ACCEL LONG CAL | 1,002 | -0,057
ACCEL LAT CAL | 1,012 | 0,040
ACCEL VERT CAL | 1,003 | -0,003
START OF MEASUREMENT | 01/06/2022 | 11:41:36 | GMT+00:00
END OF MEASUREMENT | 01/06/2022 | 11:42:31 | GMT+00:00
STANDARD CONFIG | LOGGER AND DISPLAY NON-STANDARD
ERROR DURING TEST | NO ERRORS
UNIT SERIAL | 22306
TOTAL TIME | 54370 | [mS]
TIME GPS SPEED WENT OVER 2KPH | 4620 | [mS]
TIME GPS SPEED WENT UNDER 2KPH | 36830 | [mS]
PEAK GPS SPEED | 111,20 | [kph]
TIME OF PEAK GPS SPEED | 17630 | [mS]
PEAK SPEED | 111,66 | [kph]
TIME OF PEAK SPEED | 17540 | [mS]
TIME ACC WENT OVER 1m/s/s | 17430 | [mS]
PEAK ACC | 10,64 | [m/s/s]
TIME OF PEAK ACC | 18920 | [mS]
PEAK PITCH | 12,02 | [deg]
TIME OF PEAK PITCH | 37670 | [mS]
PEAK SLIP | 178,90 | [deg]
TIME OF PEAK SLIP | 45840 | [mS]
AVERAGE LONG ACCEL AT START | -0,21 | [m/s/s]
AVERAGE LAT ACCEL AT START | -0,22 | [m/s/s]
AVERAGE VERT ACCEL AT START | 9,80 | [m/s/s]
AVERAGE PITCH RATE AT START | 0,27 | [deg/s]
AVERAGE LONG ACCEL AT END | -1,01 | [m/s/s]
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
