rielvanm/VRI_Datalogger_/Testen/Testdag/Mov1Log/RT040418/001_22306_180404_075156.CSV

FILE NAME | 001_22306_180404_075156.CSV
HASHCODE | 81A0F405CBD27D59DCE0FD5FAE8822B25C720A13BEFDC6430504F5D774D67A43
GYRO CAL | -0,000 | 0,884 | 0,013 | -0,862
ACCEL LONG CAL | 1,002 | -0,057
ACCEL LAT CAL | 1,012 | 0,040
ACCEL VERT CAL | 1,003 | -0,003
START OF MEASUREMENT | 18/04/2004 | 07:51:56 | GMT+00:00
END OF MEASUREMENT | 18/04/2004 | 07:52:24 | GMT+00:00
STANDARD CONFIG | LOGGER AND DISPLAY NON-STANDARD
ERROR DURING TEST | NO ERRORS
UNIT SERIAL | 22306
TOTAL TIME | 27910 | [mS]
TIME GPS SPEED WENT OVER 2KPH | 9140 | [mS]
TIME GPS SPEED WENT UNDER 2KPH |  | [mS]
PEAK GPS SPEED | 48,28 | [kph]
TIME OF PEAK GPS SPEED | 16540 | [mS]
PEAK SPEED | 48,19 | [kph]
TIME OF PEAK SPEED | 16400 | [mS]
TIME ACC WENT OVER 1m/s/s | 12730 | [mS]
PEAK ACC | 4,29 | [m/s/s]
TIME OF PEAK ACC | 23050 | [mS]
PEAK PITCH | 1,34 | [deg]
TIME OF PEAK PITCH | 27080 | [mS]
PEAK SLIP | 20,41 | [deg]
TIME OF PEAK SLIP | 27740 | [mS]
AVERAGE LONG ACCEL AT START | -0,01 | [m/s/s]
AVERAGE LAT ACCEL AT START | -0,00 | [m/s/s]
AVERAGE VERT ACCEL AT START | 9,81 | [m/s/s]
AVERAGE PITCH RATE AT START | 0,04 | [deg/s]
AVERAGE LONG ACCEL AT END | -1,77 | [m/s/s]
AVERAGE LAT ACCEL AT END | 0,48 | [m/s/s]
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
