rielvanm/VRI_Datalogger_/Testen/Testdag/Mov1Log/RT040418/002_22306_180404_075402.CSV

FILE NAME | 002_22306_180404_075402.CSV
HASHCODE | 7DEE4E2F99C38060467B786BB1F3094A16CA1F9F39C42835BD9CB1D5D4DCF111
GYRO CAL | -0,000 | 0,884 | 0,013 | -0,862
ACCEL LONG CAL | 1,002 | -0,057
ACCEL LAT CAL | 1,012 | 0,040
ACCEL VERT CAL | 1,003 | -0,003
START OF MEASUREMENT | 18/04/2004 | 07:54:03 | GMT+00:00
END OF MEASUREMENT | 18/04/2004 | 07:54:28 | GMT+00:00
STANDARD CONFIG | LOGGER AND DISPLAY NON-STANDARD
ERROR DURING TEST | NO ERRORS
UNIT SERIAL | 22306
TOTAL TIME | 25250 | [mS]
TIME GPS SPEED WENT OVER 2KPH | 6490 | [mS]
TIME GPS SPEED WENT UNDER 2KPH | 90 | [mS]
PEAK GPS SPEED | 57,17 | [kph]
TIME OF PEAK GPS SPEED | 19290 | [mS]
PEAK SPEED | 57,01 | [kph]
TIME OF PEAK SPEED | 15920 | [mS]
TIME ACC WENT OVER 1m/s/s | 10230 | [mS]
PEAK ACC | 4,13 | [m/s/s]
TIME OF PEAK ACC | 8800 | [mS]
PEAK PITCH | 1,83 | [deg]
TIME OF PEAK PITCH | 24020 | [mS]
PEAK SLIP | 20,15 | [deg]
TIME OF PEAK SLIP | 25100 | [mS]
AVERAGE LONG ACCEL AT START | -0,02 | [m/s/s]
AVERAGE LAT ACCEL AT START | -0,02 | [m/s/s]
AVERAGE VERT ACCEL AT START | 9,82 | [m/s/s]
AVERAGE PITCH RATE AT START | 0,01 | [deg/s]
AVERAGE LONG ACCEL AT END | -2,26 | [m/s/s]
AVERAGE LAT ACCEL AT END | 0,32 | [m/s/s]
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
