rielvanm/VRI_Datalogger_/Testen/Testdag/Mov1Log/RT040418/003_22306_180404_075615.CSV

FILE NAME | 003_22306_180404_075615.CSV
HASHCODE | 733E70DE632331B0474412A75A37791E77134FC3599244A883470537E8101167
GYRO CAL | -0,000 | 0,884 | 0,013 | -0,862
ACCEL LONG CAL | 1,002 | -0,057
ACCEL LAT CAL | 1,012 | 0,040
ACCEL VERT CAL | 1,003 | -0,003
START OF MEASUREMENT | 18/04/2004 | 07:56:15 | GMT+00:00
END OF MEASUREMENT | 18/04/2004 | 07:56:42 | GMT+00:00
STANDARD CONFIG | LOGGER AND DISPLAY NON-STANDARD
ERROR DURING TEST | NO ERRORS
UNIT SERIAL | 22306
TOTAL TIME | 26420 | [mS]
TIME GPS SPEED WENT OVER 2KPH | 5960 | [mS]
TIME GPS SPEED WENT UNDER 2KPH | 170 | [mS]
PEAK GPS SPEED | 70,96 | [kph]
TIME OF PEAK GPS SPEED | 17760 | [mS]
PEAK SPEED | 71,19 | [kph]
TIME OF PEAK SPEED | 17610 | [mS]
TIME ACC WENT OVER 1m/s/s | 9860 | [mS]
PEAK ACC | 4,89 | [m/s/s]
TIME OF PEAK ACC | 25440 | [mS]
PEAK PITCH | 1,63 | [deg]
TIME OF PEAK PITCH | 23280 | [mS]
PEAK SLIP | 21,66 | [deg]
TIME OF PEAK SLIP | 25160 | [mS]
AVERAGE LONG ACCEL AT START | -0,11 | [m/s/s]
AVERAGE LAT ACCEL AT START | 0,10 | [m/s/s]
AVERAGE VERT ACCEL AT START | 9,82 | [m/s/s]
AVERAGE PITCH RATE AT START | -0,01 | [deg/s]
AVERAGE LONG ACCEL AT END | -0,44 | [m/s/s]
AVERAGE LAT ACCEL AT END | -0,17 | [m/s/s]
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
