rielvanm/VRI_Datalogger_/Testen/Testdag/Mov1Log/RT040418/004_22306_180404_075839.CSV

FILE NAME | 004_22306_180404_075839.CSV
HASHCODE | 8A5EC35F4EDB1B1BEF4D6CA136CC8EAAE2E5F0044C77EF33B5FAA93B5D2217A1
GYRO CAL | -0,000 | 0,884 | 0,013 | -0,862
ACCEL LONG CAL | 1,002 | -0,057
ACCEL LAT CAL | 1,012 | 0,040
ACCEL VERT CAL | 1,003 | -0,003
START OF MEASUREMENT | 18/04/2004 | 07:58:40 | GMT+00:00
END OF MEASUREMENT | 18/04/2004 | 07:59:10 | GMT+00:00
STANDARD CONFIG | LOGGER AND DISPLAY NON-STANDARD
ERROR DURING TEST | NO ERRORS
UNIT SERIAL | 22306
TOTAL TIME | 30530 | [mS]
TIME GPS SPEED WENT OVER 2KPH | 5440 | [mS]
TIME GPS SPEED WENT UNDER 2KPH | 30 | [mS]
PEAK GPS SPEED | 76,61 | [kph]
TIME OF PEAK GPS SPEED | 17220 | [mS]
PEAK SPEED | 77,12 | [kph]
TIME OF PEAK SPEED | 17060 | [mS]
TIME ACC WENT OVER 1m/s/s | 8570 | [mS]
PEAK ACC | 5,92 | [m/s/s]
TIME OF PEAK ACC | 28180 | [mS]
PEAK PITCH | 2,43 | [deg]
TIME OF PEAK PITCH | 28190 | [mS]
PEAK SLIP | 27,79 | [deg]
TIME OF PEAK SLIP | 30430 | [mS]
AVERAGE LONG ACCEL AT START | -0,16 | [m/s/s]
AVERAGE LAT ACCEL AT START | 0,02 | [m/s/s]
AVERAGE VERT ACCEL AT START | 9,83 | [m/s/s]
AVERAGE PITCH RATE AT START | 0,05 | [deg/s]
AVERAGE LONG ACCEL AT END | -1,97 | [m/s/s]
AVERAGE LAT ACCEL AT END | 0,90 | [m/s/s]
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
