rielvanm/VRI_Datalogger_/Testen/Testdag/Mov1Log/RT040418/005_22306_180404_080100.CSV

FILE NAME | 005_22306_180404_080100.CSV
HASHCODE | 491534CB2104CAD37C27809C93C95494573844045A75C278E59DE8A773384C8F
GYRO CAL | -0,000 | 0,884 | 0,013 | -0,862
ACCEL LONG CAL | 1,002 | -0,057
ACCEL LAT CAL | 1,012 | 0,040
ACCEL VERT CAL | 1,003 | -0,003
START OF MEASUREMENT | 18/04/2004 | 08:01:00 | GMT+00:00
END OF MEASUREMENT | 18/04/2004 | 08:01:39 | GMT+00:00
STANDARD CONFIG | LOGGER AND DISPLAY NON-STANDARD
ERROR DURING TEST | NO ERRORS
UNIT SERIAL | 22306
TOTAL TIME | 38840 | [mS]
TIME GPS SPEED WENT OVER 2KPH | 5970 | [mS]
TIME GPS SPEED WENT UNDER 2KPH | 170 | [mS]
PEAK GPS SPEED | 95,22 | [kph]
TIME OF PEAK GPS SPEED | 24150 | [mS]
PEAK SPEED | 95,20 | [kph]
TIME OF PEAK SPEED | 23330 | [mS]
TIME ACC WENT OVER 1m/s/s | 9520 | [mS]
PEAK ACC | 7,24 | [m/s/s]
TIME OF PEAK ACC | 29020 | [mS]
PEAK PITCH | 2,69 | [deg]
TIME OF PEAK PITCH | 31230 | [mS]
PEAK SLIP | 40,85 | [deg]
TIME OF PEAK SLIP | 33760 | [mS]
AVERAGE LONG ACCEL AT START | -0,13 | [m/s/s]
AVERAGE LAT ACCEL AT START | 0,04 | [m/s/s]
AVERAGE VERT ACCEL AT START | 9,83 | [m/s/s]
AVERAGE PITCH RATE AT START | -0,02 | [deg/s]
AVERAGE LONG ACCEL AT END | -1,10 | [m/s/s]
AVERAGE LAT ACCEL AT END | 0,38 | [m/s/s]
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
