rielvanm/VRI_Datalogger_/Testen/Testdag/Mov1Log/RT040418/006_22306_180404_080516.CSV

FILE NAME | 006_22306_180404_080516.CSV
HASHCODE | 37D3355E7BD6290FA7303BFD16F82E695F8D1C8B4759AC9675AFF3D3567BD927
GYRO CAL | -0,000 | 0,884 | 0,013 | -0,862
ACCEL LONG CAL | 1,002 | -0,057
ACCEL LAT CAL | 1,012 | 0,040
ACCEL VERT CAL | 1,003 | -0,003
START OF MEASUREMENT | 18/04/2004 | 08:05:16 | GMT+00:00
END OF MEASUREMENT | 18/04/2004 | 08:06:16 | GMT+00:00
STANDARD CONFIG | LOGGER AND DISPLAY NON-STANDARD
ERROR DURING TEST | NO ERRORS
UNIT SERIAL | 22306
TOTAL TIME | 59700 | [mS]
TIME GPS SPEED WENT OVER 2KPH | 5420 | [mS]
TIME GPS SPEED WENT UNDER 2KPH | 49020 | [mS]
PEAK GPS SPEED | 95,51 | [kph]
TIME OF PEAK GPS SPEED | 23210 | [mS]
PEAK SPEED | 95,63 | [kph]
TIME OF PEAK SPEED | 22080 | [mS]
TIME ACC WENT OVER 1m/s/s | 8610 | [mS]
PEAK ACC | 6,65 | [m/s/s]
TIME OF PEAK ACC | 32050 | [mS]
PEAK PITCH | 5,47 | [deg]
TIME OF PEAK PITCH | 50610 | [mS]
PEAK SLIP | 149,66 | [deg]
TIME OF PEAK SLIP | 59610 | [mS]
AVERAGE LONG ACCEL AT START | -0,17 | [m/s/s]
AVERAGE LAT ACCEL AT START | 0,06 | [m/s/s]
AVERAGE VERT ACCEL AT START | 9,83 | [m/s/s]
AVERAGE PITCH RATE AT START | -0,01 | [deg/s]
AVERAGE LONG ACCEL AT END | 0,33 | [m/s/s]
AVERAGE LAT ACCEL AT END | 0,10 | [m/s/s]
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
