rielvanm/VRI_Datalogger_/Wire_diagram/Aansluitschema_schema_V0.2.pdf

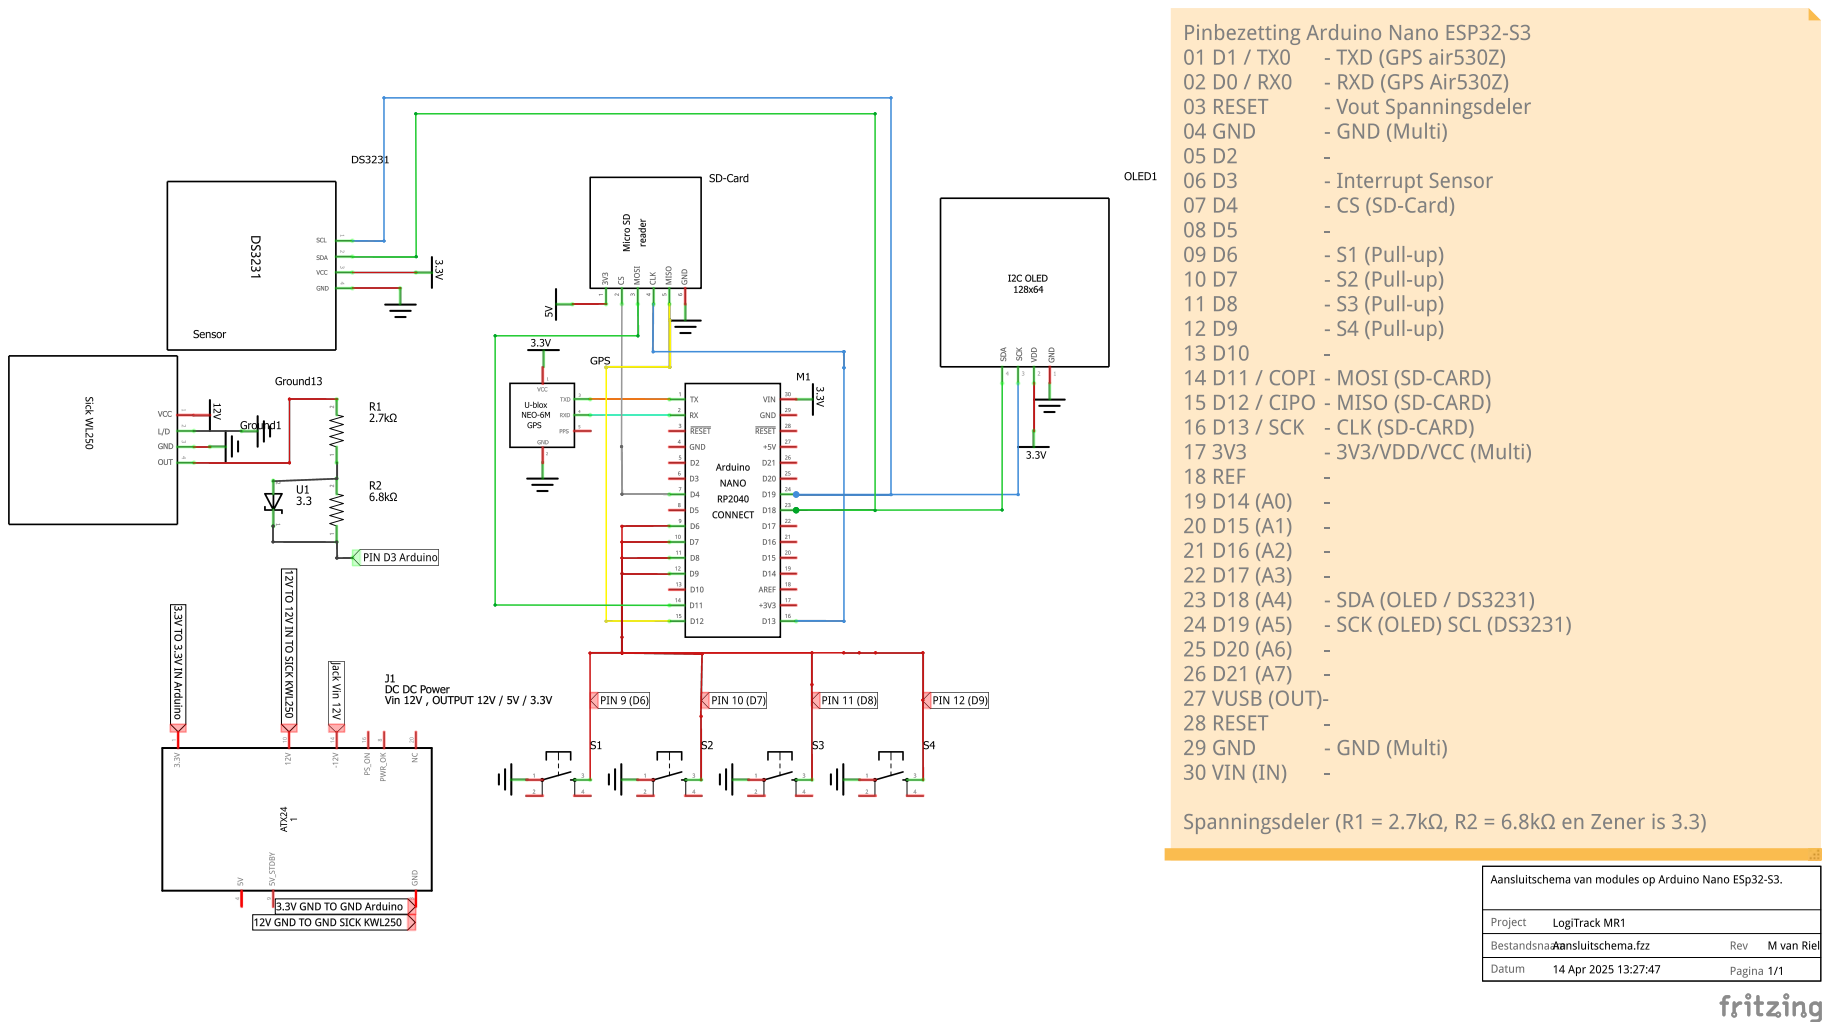
[picture p87: page 1]
