rielvanm/VRI_Datalogger_/Wire_diagram/Aansluitschema_schema_V0.1.pdf

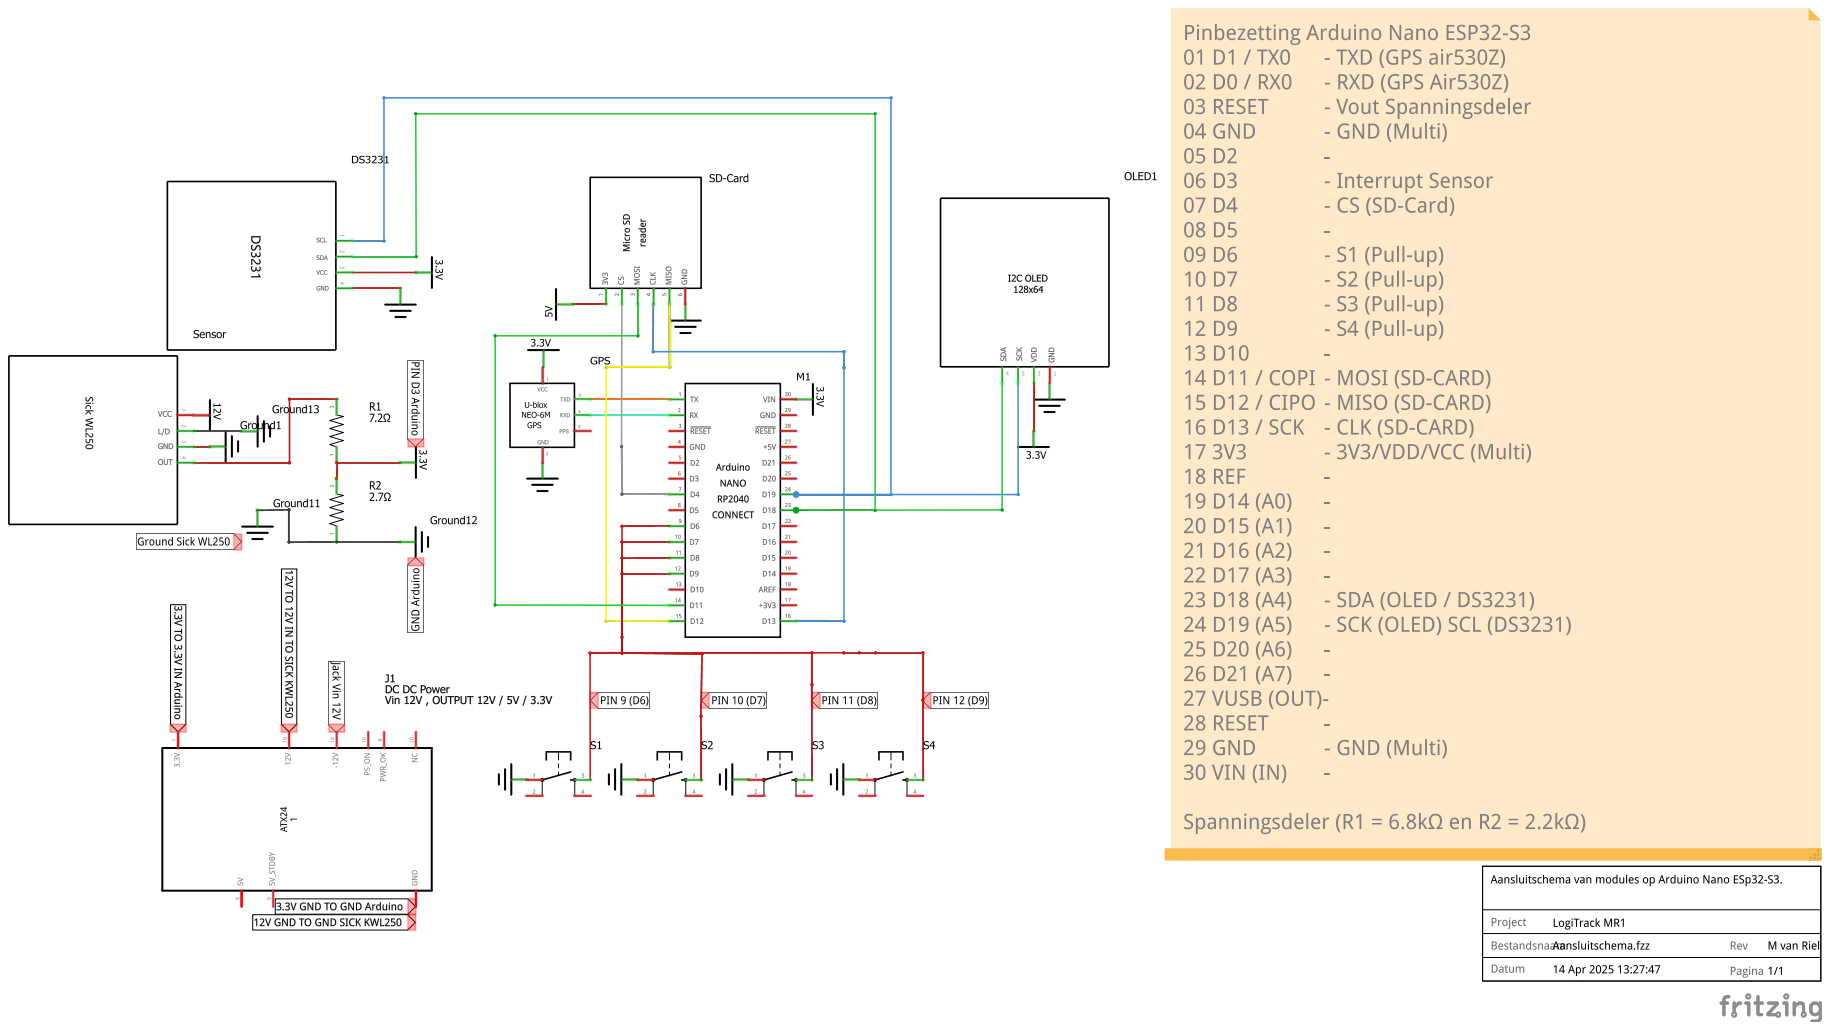
[picture p88: page 1]
