rielvanm/VRI_Datalogger_/Wire_diagram/Aansluitschema_schema.pdf

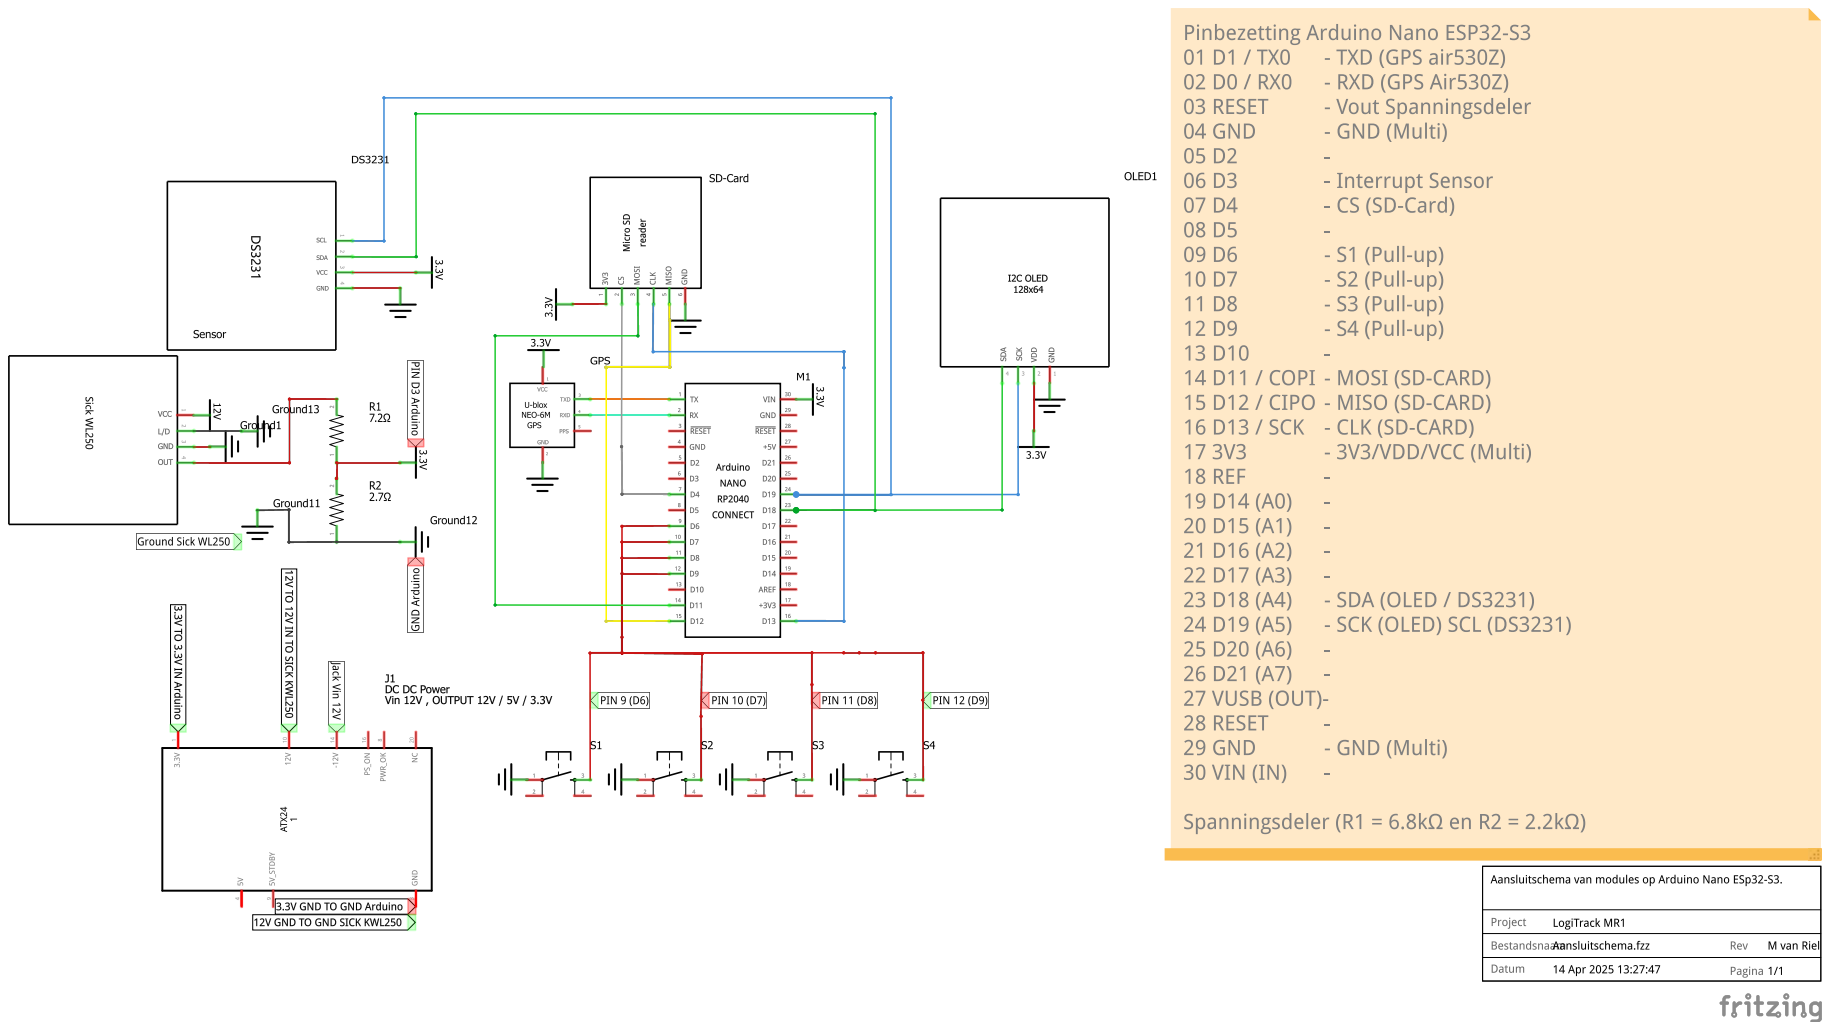
[picture p89: page 1]
