rielvanm/VRI_Datalogger_/(list of files, drawings)

Other design files:
Productdocument_bijlagen/Aansluitschema.fzz
Testen/Testdag/Mov1Log/lasertrigger_lay3.Lay
Testen/Testdag/Mov1Log/movilog_difftest_lay.Lay
Wire_diagram/Aansluitschema.fzz
