rielvanm/VRI_Datalogger_/Plan van Aanpak/Onderzoek_Bijlage/Grove GPS/Grove - GPS (Air530)_v1.0_©¢╝■Î╩┴¤/Grove - GPS (Air530)_v1.0_191111.brd

## EAGLE design Plan van Aanpak/Onderzoek_Bijlage/Grove GPS/Grove - GPS (Air530)_v1.0_©¢╝■Î╩┴¤/Grove - GPS (Air530)_v1.0_191111.brd (2025-03-31)

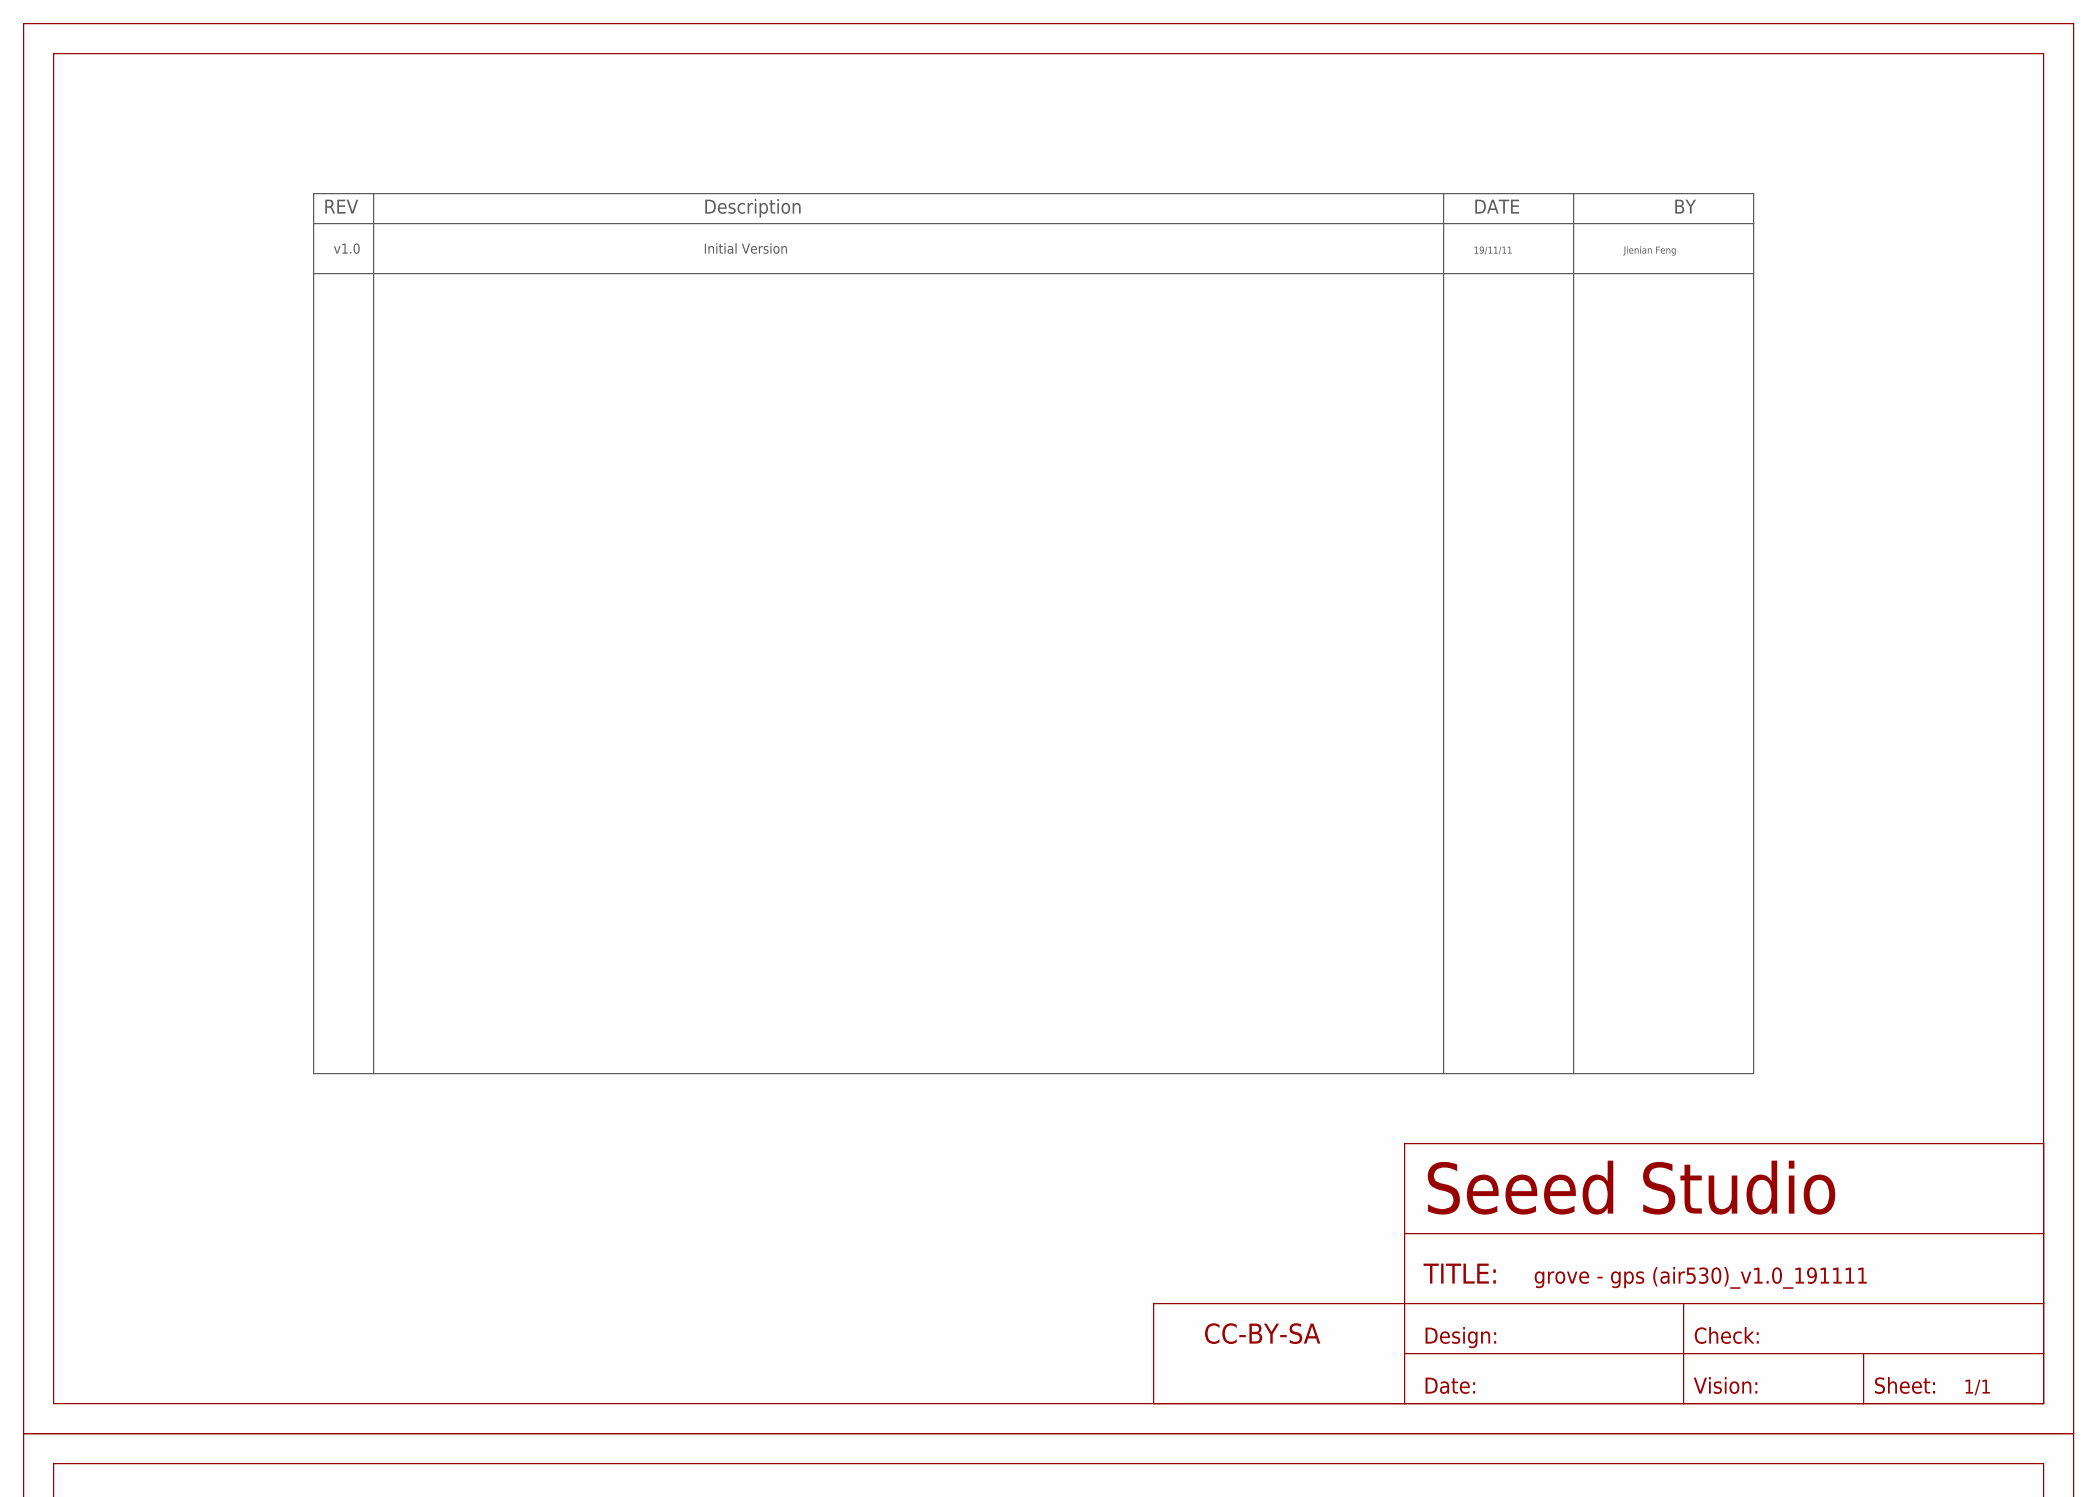
[picture p90: schematic Grove - GPS (Air530)_v1.0_191111.sch, part in row 1, column 1]

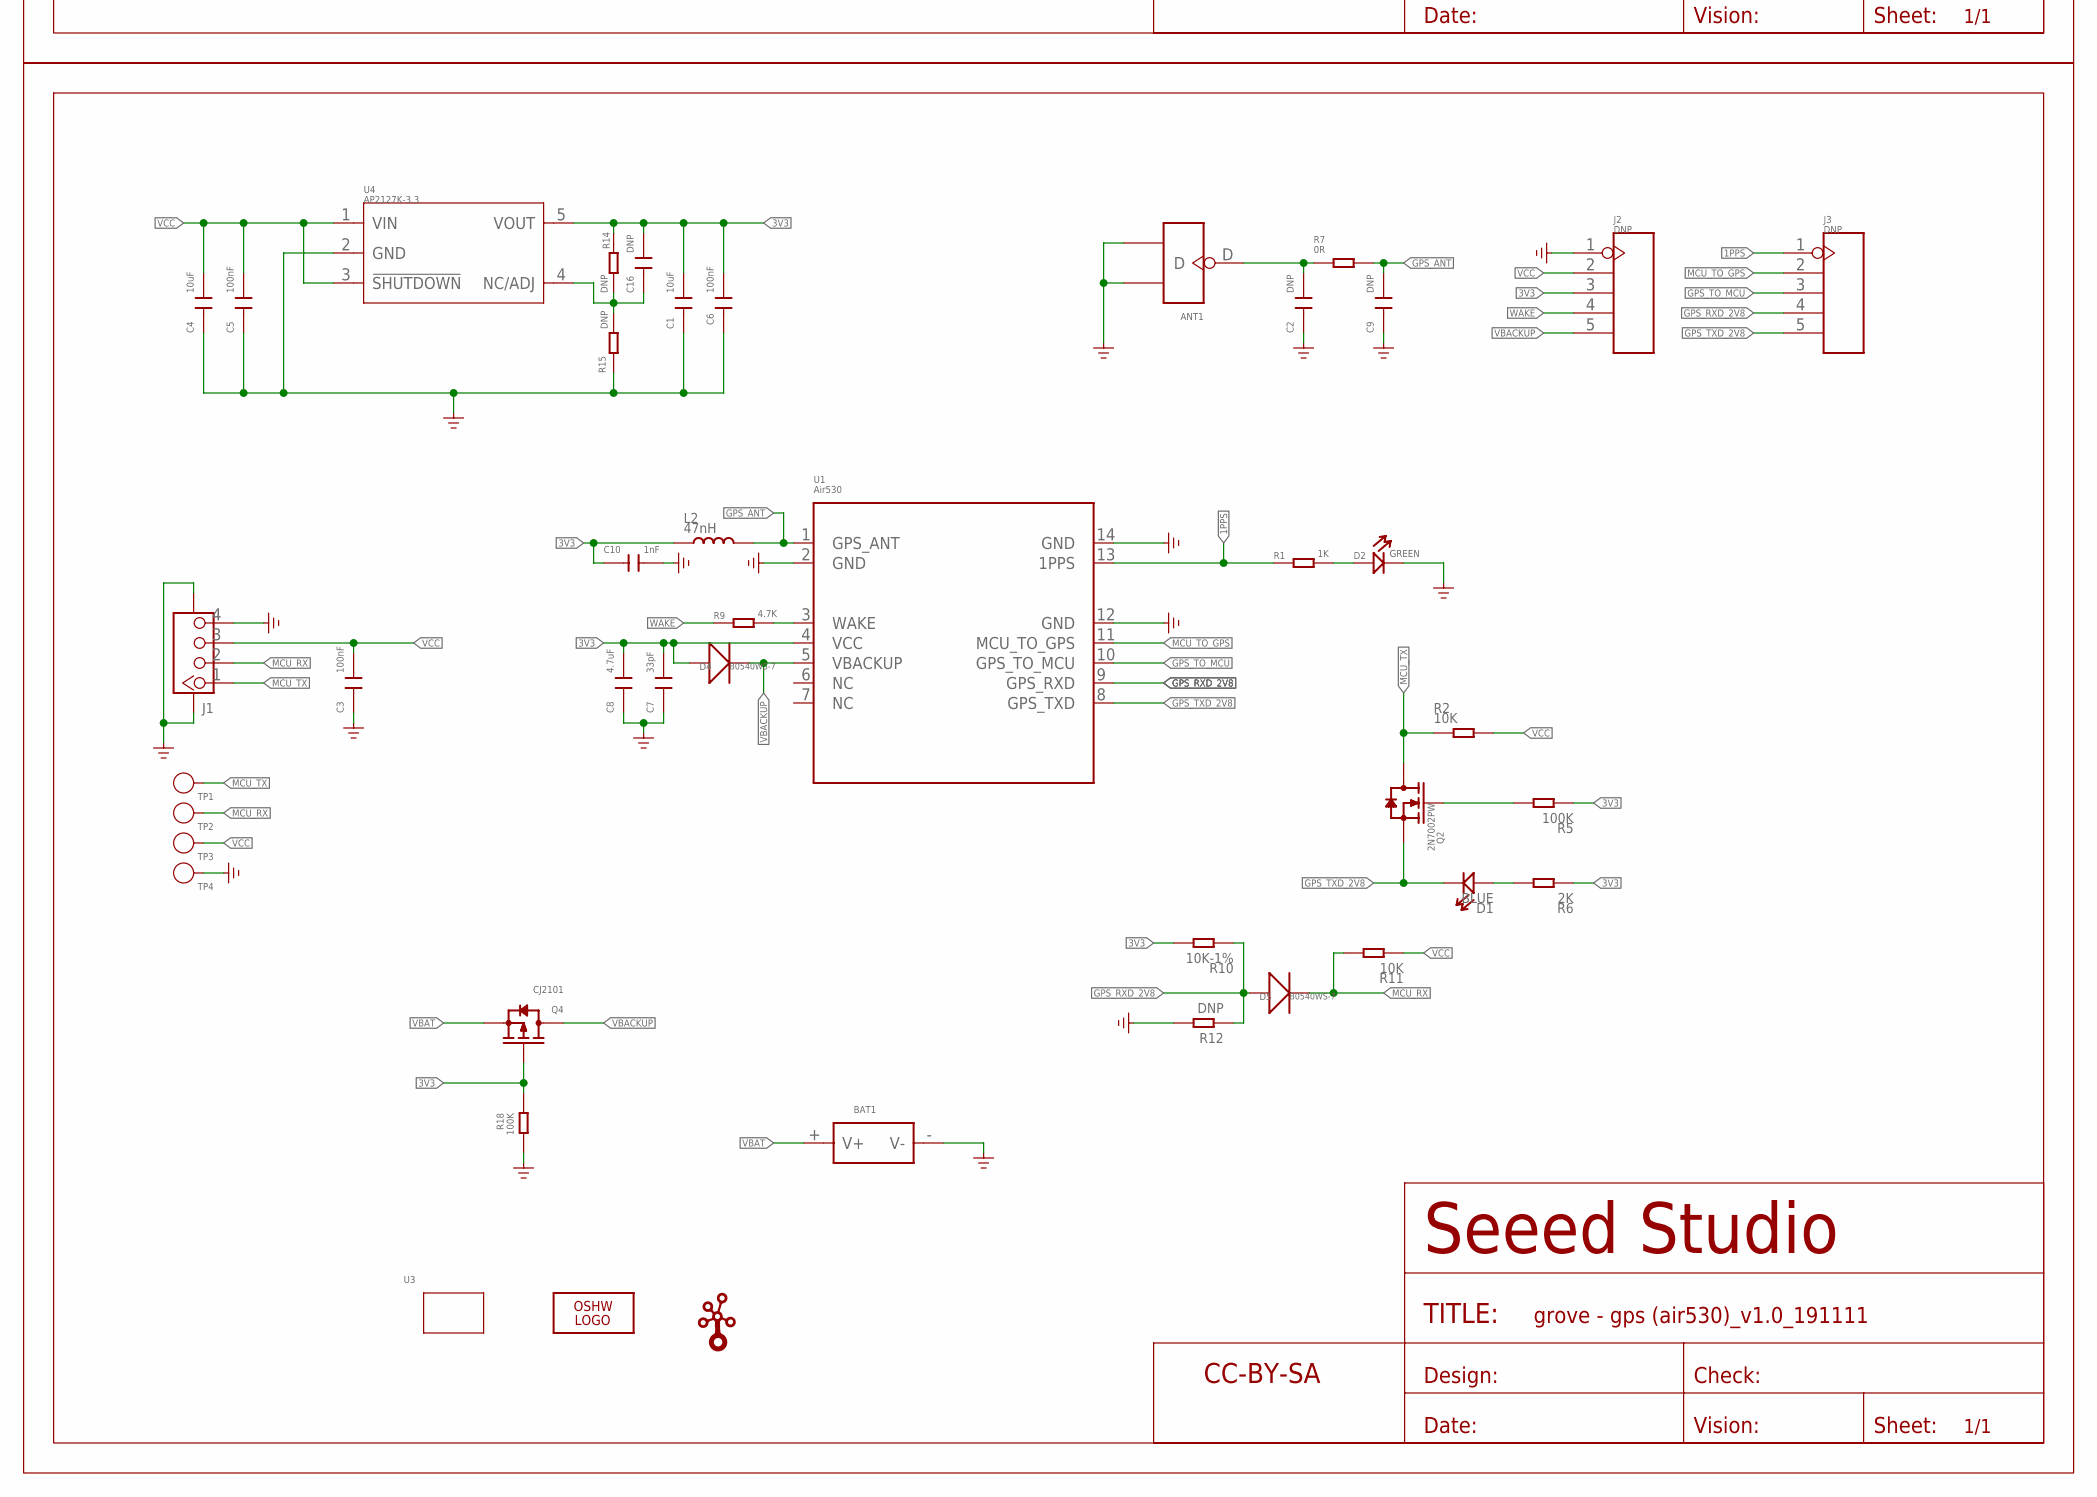
[picture p91: schematic Grove - GPS (Air530)_v1.0_191111.sch, part in row 2, column 1]

Parts:
ANT1: ANTENNA-U-FL-320110048; U-FL3P-SMD-2.6X2.6X1.0MM
BAT1: BAT-HOLDER'SMD-1220'; BAT2P-SMD-16.4-CR1220
C1, C4: 10uF; C0603
C2, C9, C16: DNP; C0402
C3, C5, C6: 100nF; C0402
C7: 33pF; C0402
C8: 4.7uF; C0402
C10: 1nF; C0402
D1: BLUE; LED-0402
D2: GREEN; LED-0402
D4, D5: B0540WS-7; SOD323
FR1, FR2: SEEEDSTUDIO-OPEN-SCH-FRAME; SEEEDSTUDIO-PCB-FRAME
J1: GROVE-CONNECTOR-SMD-320110030; HW4-SMD-2.0
J2, J3: DNP; H5-2.54
L2: 47nH; L0402
LOGO1: LOGO-OSHW-FILLX0200-NT; OSHW_FILLX200_NOTEXT
Q2: 2N7002PW; SOT-323
Q4: CJ2101; SOT-323
R1: 1K; R0402
R2, R11: 10K; R0402
R5, R18: 100K; R0402
R6: 2K; R0402
R7: 0R; R0402
R9: 4.7K; R0402
R10: 10K-1%; R0402
R12, R14, R15: DNP; R0402
TP1, TP2, TP3, TP4: TEST-POINT'4545'; TP-D45MIL
U1: Air530; MOUDLE14-GPS-9.9X12.9MM
U3: GROVE-1X2-TOP; GROVE-1*2-TEST-PLATFORM-TOP
U4: AP2127K-3.3; SOT-23-5
U$1: LOGO-GROVE; GROVE-SILK-BIG

Connections:
1PPS: J3.1, R1.1, U1.13 (1PPS)
3V3: C1.2, C6.2, C7.2, C8.2, C10.1, C16.2, D4.+, J2.3, L2.1, Q4.1 (G), R5.1, R6.1, R10.2, R14.2, R18.1, U1.4 (VCC), U4.5 (VOUT)
GND: ANT1.GND1, ANT1.GND2, BAT1.- (V-), C1.1, C2.1, C3.1, C4.1, C5.1, C6.1, C7.1, C8.1, C9.1, C10.2, D2.-, J1.4, J1.SS1, J1.SS2, J2.1, R12.2, R15.1, R18.2, TP4.T, U1.2 (GND), U1.12 (GND), U1.14 (GND), U4.2 (GND)
GPS_ANT: C9.2, L2.2, R7.2, U1.1 (GPS_ANT)
GPS_RXD_2V8: D5.+, J3.4, R10.1, R12.1, U1.9 (GPS_RXD)
GPS_TO_MCU: J3.3, U1.10 (GPS_TO_MCU)
GPS_TXD_2V8: D1.-, J3.5, Q2.2 (S), U1.8 (GPS_TXD)
MCU_RX: D5.-, J1.2, R11.2, TP2.T
MCU_TO_GPS: J3.2, U1.11 (MCU_TO_GPS)
MCU_TX: J1.1, Q2.3 (D), R2.1, TP1.T
unnamed: D2.+, R1.2
unnamed: ANT1.D, C2.2, R7.1
unnamed: R9.2, U1.3 (WAKE)
unnamed: C16.1, R14.1, R15.2, U4.4 (NC/ADJ)
unnamed: D1.+, R6.2
unnamed: Q2.1 (G), R5.2
VBACKUP: D4.-, J2.5, Q4.3 (D), U1.5 (VBACKUP)
VBAT: BAT1.+ (V+), Q4.2 (S)
VCC: C3.2, C4.2, C5.2, J1.3, J2.2, R2.2, R11.1, TP3.T, U4.1 (VIN), U4.3 (!SHUTDOWN)
WAKE: J2.4, R9.1

Notes on the sheet:
v1.0
Initial Version
19/11/11
Jienian Feng

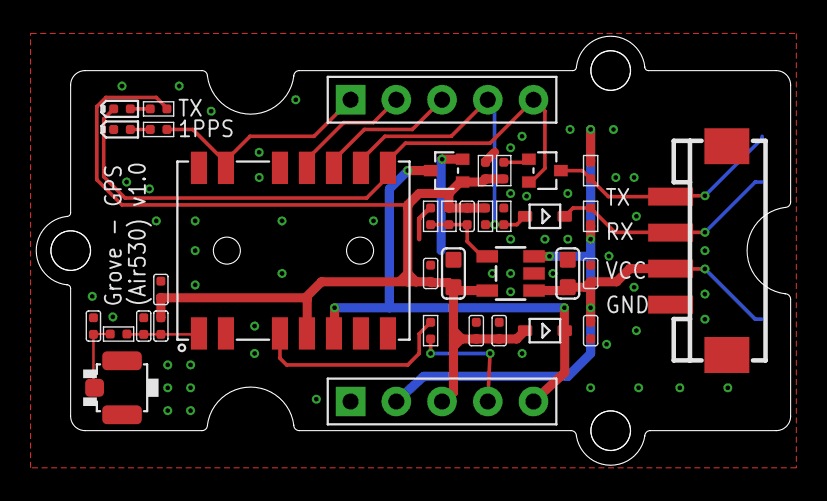
[picture p92: board Grove - GPS (Air530)_v1.0_191111.brd from above]

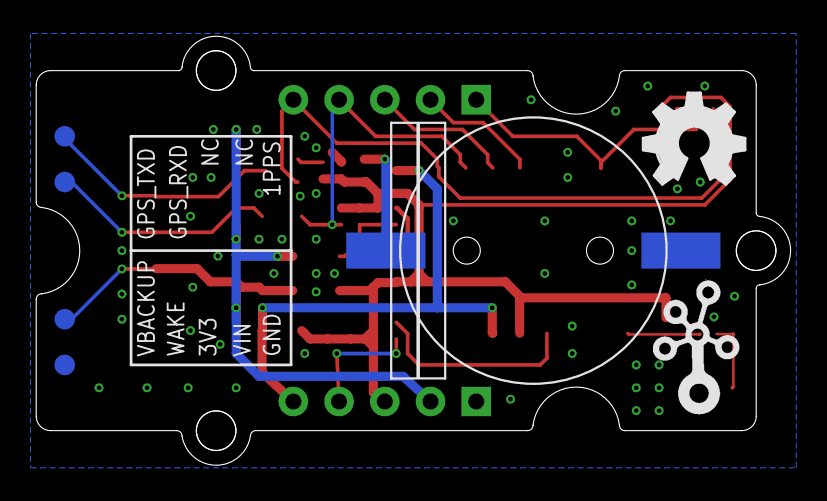
[picture p93: board Grove - GPS (Air530)_v1.0_191111.brd from below]

Board: 2 copper layers, 41.9 x 23.8 mm, 46 parts (7 on the bottom side), 20 nets.
