rielvanm/VRI_Datalogger_/Code/Code_logger/Relatief_Absoluut/LogiTrack_MR1/logo.cpp

/**
 * @file logo.h
 * @brief Contains a bitmap of the Arduino logo for OLED displays.
 *
 * This header defines a statically stored bitmap image of the Arduino logo,
 * stored in PROGMEM to save RAM. The image is 128x64 pixels and suitable for
 * use with OLED displays such as the SSD1306.
 *
 * The bitmap can be rendered using libraries like Adafruit_SSD1306 or U8g2.
 */


#include <Arduino.h>        // Core Arduino definitions
#include "logo.h"           // Header file that declares the logo array (optional, good for reuse)

/**
 * @brief Bitmap image of the Arduino logo (128x64 pixels).
 * 
 * Stored in PROGMEM to keep it out of SRAM and reduce RAM usage.
 * Each byte represents 8 vertical pixels (for use with displays like SSD1306).
 * This image can be displayed using display libraries such as Adafruit_SSD1306:
 * 
 * Example usage:
 *   display.drawBitmap(0, 0, arduino_icon, 128, 64, WHITE);
 */
const unsigned char arduino_icon[] PROGMEM = {
  // 'arduino-icon', 128x64px
0x00, 0x00, 0x00, 0x00, 0x00, 0x00, 0x00, 0x00, 0x00, 0x00, 0x00, 0x00, 0x00, 0x00, 0x00, 0x00, 
0x00, 0x00, 0x00, 0x0c, 0x00, 0x00, 0x00, 0x00, 0x00, 0x00, 0x00, 0x00, 0x00, 0x00, 0x00, 0x00, 
0x00, 0x00, 0x00, 0x0c, 0x00, 0x00, 0x00, 0x00, 0x00, 0x00, 0x00, 0x00, 0x00, 0x00, 0x00, 0x00, 
0x00, 0x00, 0x00, 0x0e, 0x00, 0x00, 0x00, 0x00, 0x00, 0x00, 0x00, 0x00, 0x00, 0x00, 0x00, 0x00, 
0x00, 0x00, 0x00, 0x0e, 0x00, 0x00, 0x00, 0x00, 0x00, 0x00, 0x00, 0x00, 0x00, 0x00, 0x00, 0x00, 
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
0x00, 0x00, 0x0f, 0x80, 0x3e, 0x00, 0x00, 0x00, 0x00, 0x00, 0x00, 0x00, 0x00, 0x00, 0x00, 0x00, 
0x00, 0x00, 0x0f, 0x80, 0x3c, 0x00, 0x00, 0x00, 0x00, 0x00, 0x00, 0x00, 0x00, 0x00, 0x00, 0x00, 
0x00, 0x00, 0x07, 0x80, 0x7c, 0x00, 0x00, 0x00, 0x00, 0x00, 0x00, 0x00, 0x00, 0x00, 0x00, 0x00, 
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
};
