rielvanm/VRI_Datalogger_/(commit log)

2025-02-24 Research is almost complete..
    [Afstudeerplanning_Datalogger.xlsm, Afstudeerplanning_Datalogger.xlsx]
2025-03-05 Research is almost complete......
    [Afstudeerplanning_Datalogger.xlsm]
2025-03-09 Research is almost complete.......
    [Afstudeerplanning_Datalogger.xlsm]
2025-03-31 Skills ready!
    [Afstudeerplanning_Datalogger.xlsm, Grove - GPS (Air530)_v1.0_191111.brd, Grove - GPS (Air530)_v1.0_191111.sch, Validatie.xlsx]
2025-04-10 Code: succesfully timer in ms add
2025-04-11 Code: Timer starts always on 0
2025-04-16 Code saving data on SD
    [Aansluitschema.fzz]
2025-04-17 Timer is working fine
2025-04-18 Code: Menu ready
    [Aansluitschema.fzz, Afstudeerplanning_Datalogger.xlsm]
2025-05-03 Fine tuning is ready..
    [Aansluitschema.fzz]
2025-05-14 Productrapport in progress
    [001_22306_010116_000000.CSV, 001_22306_010622_113918.CSV, 001_22306_050622_061433.CSV, 001_22306_070404_122312.CSV, 001_22306_130321_052336.CSV, 001_22306_131120_090328.CSV, 001_22306_180404_075156.CSV, 001_22306_230905_083559.CSV]
2025-05-25 Productrapport at chapter 7
    [uitwerking.xlsx]
2025-05-30 Productrapport allmost finished, one more day finetuning...
    [uitwerking.xlsx]
2026-01-17 Version 1.1 concerns a change made to the code, transition from absolute time to relative time.
    [metingen_20.csv, uitwerking.xlsx]
